seba379/PoliClock/mechanical/cad/concept_rapporto.txt

CONCEPT VOXEL v2 DELLA STATUETTA - PoliClock (DEC-053, DEC-054)
Generato da mechanical/cad/concept_voxel.py; quote in mm, Z dal tavolo.

== Quote principali ==
Ingombro totale: 78.5 (largh.) x 76.3 (prof.) x 153.1 (alt.)
Base: 78.5 x 76.3 x 24.1
Testa: 48 x 40 x 48, da Z 90.1 a 138.1; cappello fino a Z 153.1
Display: centro del vetro a Z 111.1, finestra Ø 38; piastra del volto 40 mm (cornice di pelle di 1 mm ai lati)
Aletta del modulo fino a Z 84.3 (5.8 mm dentro il busto); spina Dupont a Z 86.8, da Y -9.2 a 7.3
Stivali Z 24.1-34.1, pantaloni -58.1, cintura -62.1, busto -90.1
Testa con cappello / altezza: 0.41; altezza in teste (con cappello): 2.43

== Parti (concept) ==
base_guscio        base         31.12 cm3   78.5 x  76.3 x  24.1  - Capovolta (piano superiore sul piatto)
base_fondo         fondo        15.48 cm3   73.9 x  72.7 x  20.1  - Piatta; è lo sportello di servizio (OPEN-008)
stivale_dx         nero          3.70 cm3   17.0 x  26.0 x  10.0  - Suola sul piatto
stivale_sx         nero          3.70 cm3   17.0 x  26.0 x  10.0  - Suola sul piatto
pantaloni          pantaloni    14.56 cm3   34.0 x  22.0 x  24.0  - In piedi; banda rossa incastrata o dipinta
banda_dx           rosso         0.05 cm3    0.7 x   2.8 x  23.6  - Listello 0,8 mm: meglio dipinto se il servizio non regge lo spessore
banda_sx           rosso         0.05 cm3    0.7 x   2.8 x  23.6  - Listello 0,8 mm: meglio dipinto se il servizio non regge lo spessore
cintura            nero          4.46 cm3   49.0 x  28.1 x  17.0  - Anello con fondina e tasca; le spine Ø 3 attraversano
fibbia             grigio        0.04 cm3    8.0 x   1.6 x   2.8  - Piastrina incastrata nella cintura
busto              camicia      25.32 cm3   55.2 x  29.4 x  28.0  - In piedi; cavità in cima per l'aletta del display
braccio_dx         pelle         1.23 cm3    7.0 x  10.0 x  18.0  - Avambraccio e mano; spina Ø 3 nella manica
spallina_dx        rosso         0.12 cm3    8.5 x  10.0 x   1.4  - Piastrina 1,4 mm sulla manica
grado_dx           oro           0.01 cm3    3.5 x   6.0 x   0.6  - Dettaglio 0,6 mm: dipinto se troppo sottile per il servizio
braccio_sx         pelle         1.23 cm3    7.0 x  10.0 x  18.0  - Avambraccio e mano; spina Ø 3 nella manica
spallina_sx        rosso         0.12 cm3    8.5 x  10.0 x   1.4  - Piastrina 1,4 mm sulla manica
grado_sx           oro           0.01 cm3    3.5 x   6.0 x   0.6  - Dettaglio 0,6 mm: dipinto se troppo sottile per il servizio
targhetta          targhetta     0.05 cm3   10.8 x   0.9 x   5.3  - Piastrina
scritta_polizia    bianco        0.01 cm3   10.8 x   0.5 x   2.1  - Lettere in rilievo 0,5 mm: stampa multicolore o pittura
toppa_verde        verde         0.02 cm3    3.6 x   0.9 x   5.3  - Piastrina
toppa_bianco       bianco        0.02 cm3    3.6 x   0.9 x   5.3  - Piastrina
toppa_rosso        rosso         0.02 cm3    3.6 x   0.9 x   5.3  - Piastrina
testa_fronte       capelli       4.41 cm3   48.0 x   8.0 x  48.0  - Cornice dei capelli attorno al volto; si unisce a testa_retro (viti M2 dal pavimento)
testa_retro        capelli      23.61 cm3   55.0 x  32.0 x  48.0  - Guscio posteriore con la coda: retro sul piatto, supporti sotto la coda
volto              pelle         0.89 cm3   39.8 x   2.0 x  40.9  - Cornice 2 mm con la finestra Ø 38: il display è tutto il volto
cappello           cappello     13.37 cm3   54.0 x  47.0 x  15.0  - Capovolto (cima sul piatto): la fascia sporge di 2–5 mm
fregio             oro           0.03 cm3    9.8 x   0.8 x   9.8  - Rilievo 0,8 mm a pixel 1,4 mm

== Controlli ==
  Sovrapposizioni fra parti: PASS
  Modulo display (tondo + aletta) e spina senza interferenze: PASS (0.00 mm3)
  Canale 21 x 6 libero dalla base alla cavità del busto: PASS (0.00 mm3)
  Interferenze nella base e distanze dall'antenna: vedi studio_base_rapporto.txt (stessa base, spigoli 5/4 mm)
  Cavetto display: percorso fra le spine circa 68 mm; Dupont da 10 cm (ok, almeno 15 mm di gioco per sfilare la testa)
