seba379/PoliClock/assets/concept/policlock-chibi-concept.png

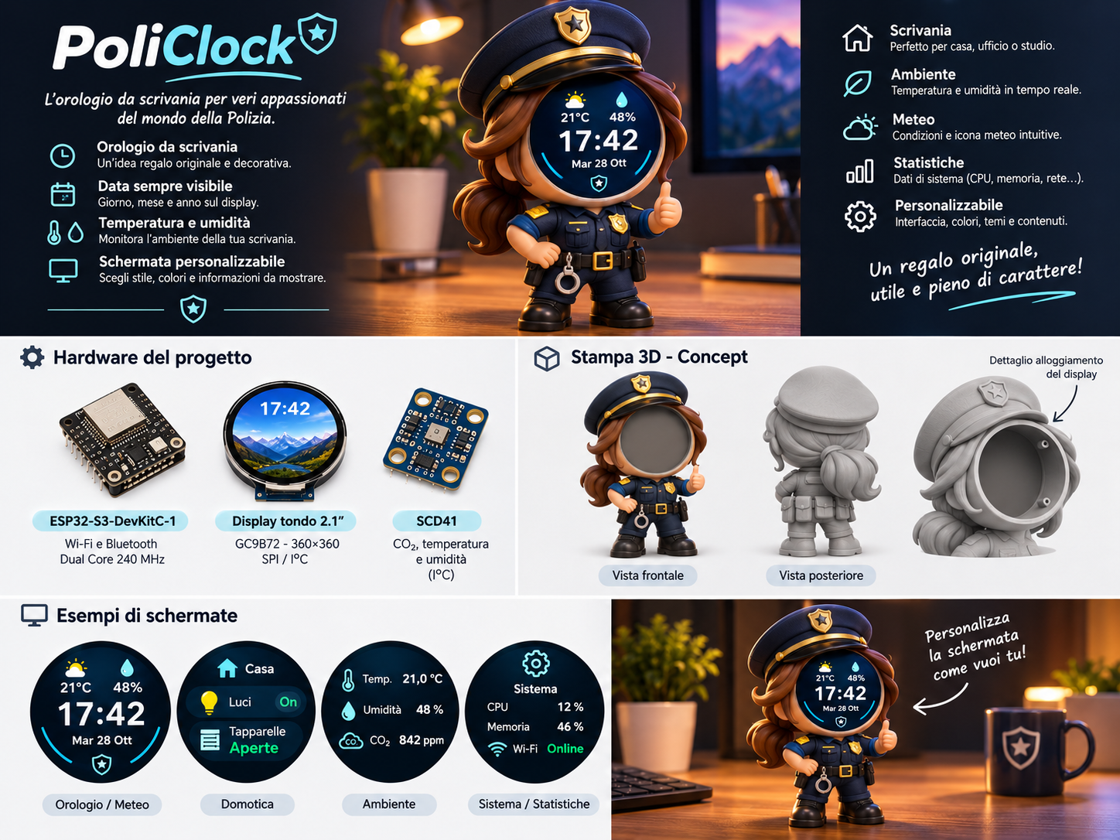
assets/concept/policlock-chibi-concept.png
