seba379/PoliClock/assets/concept/riferimento-stile-chibi-voxel.webp

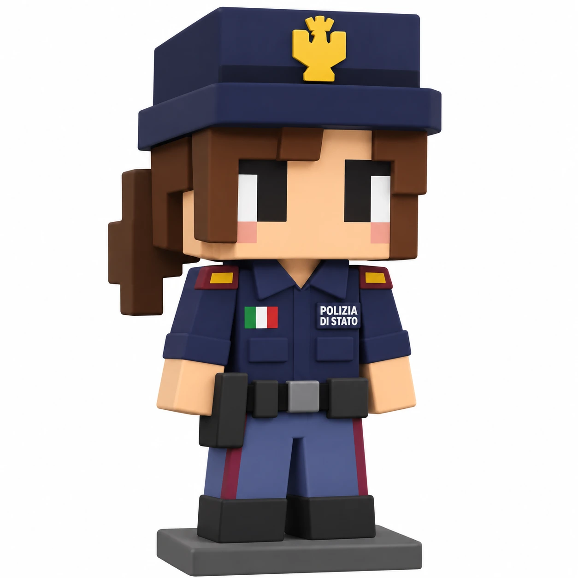
assets/concept/riferimento-stile-chibi-voxel.webp
