seba379/PoliClock/assets/renders/blockout-fronte.png

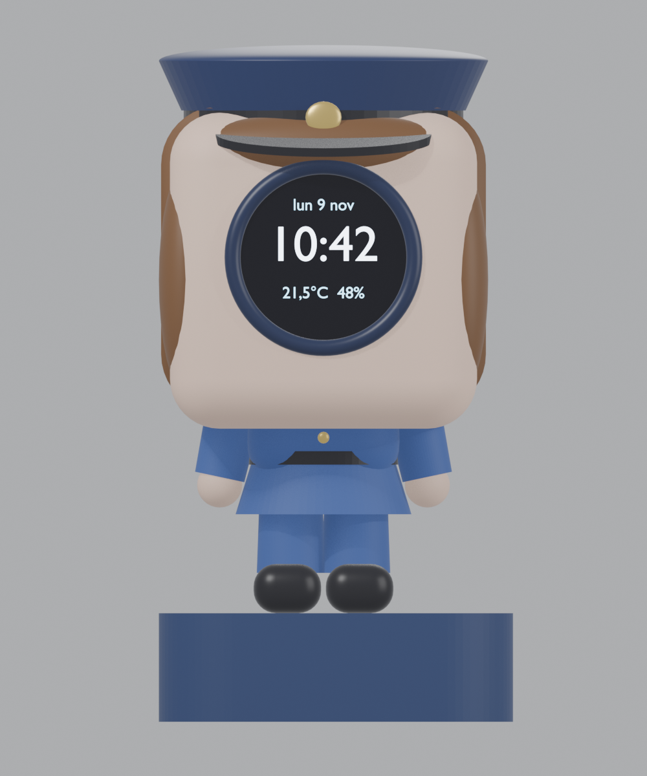
assets/renders/blockout-fronte.png
