seba379/PoliClock/assets/renders/blockout-lato.png

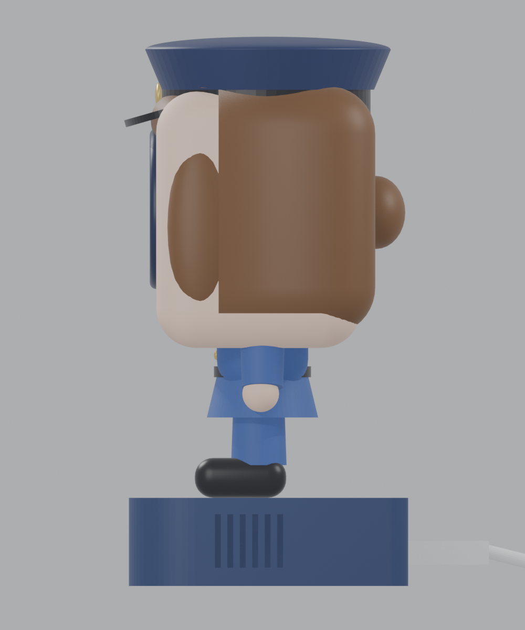
assets/renders/blockout-lato.png
