seba379/PoliClock/assets/renders/blockout-retro.png

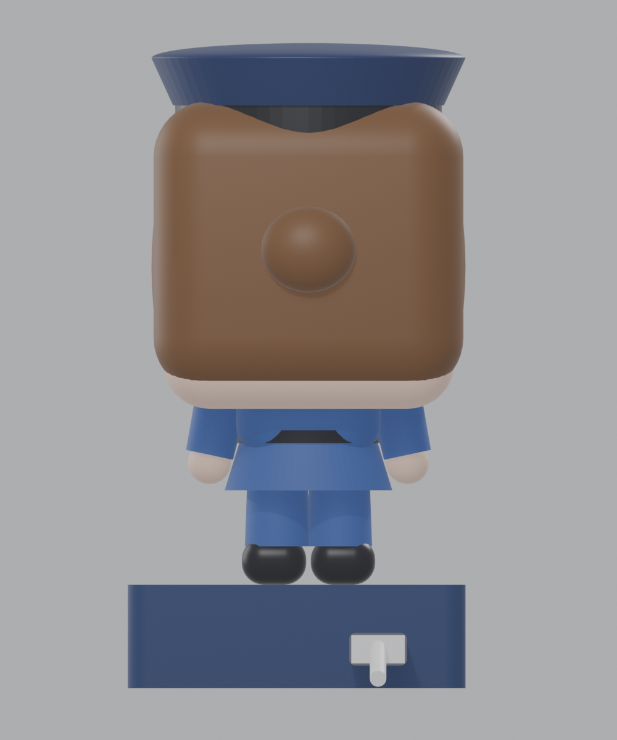
assets/renders/blockout-retro.png
