seba379/PoliClock/assets/renders/blockout-sezione-base-3q.png

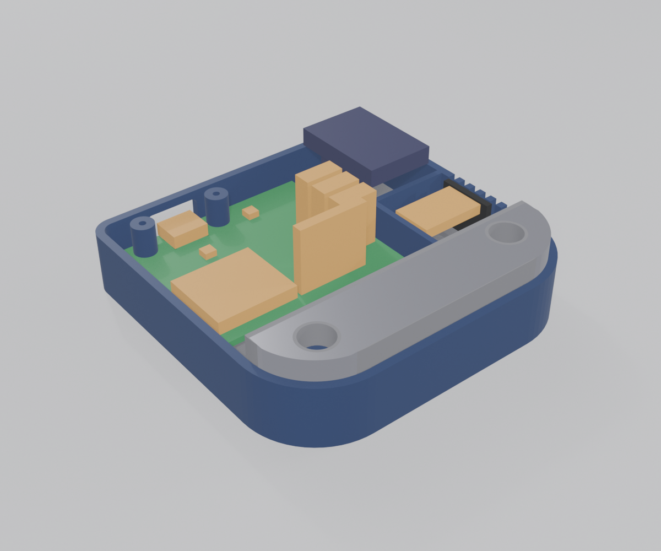
assets/renders/blockout-sezione-base-3q.png
