seba379/PoliClock/assets/renders/blockout-sezione-base.png

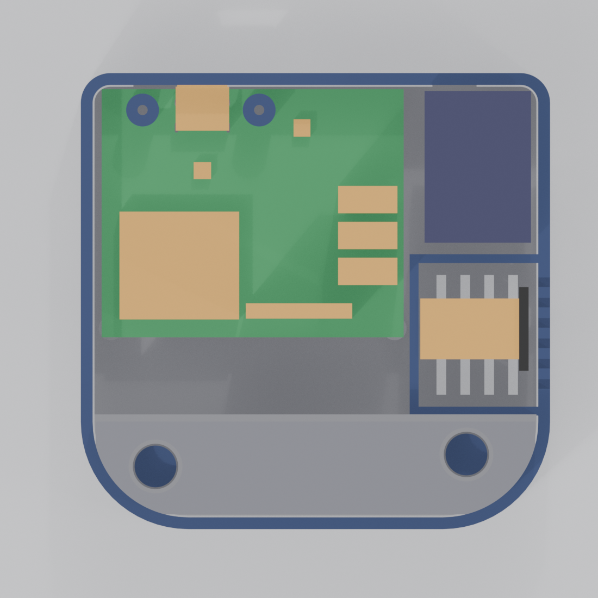
assets/renders/blockout-sezione-base.png
