seba379/PoliClock/assets/renders/blockout-tre-quarti.png

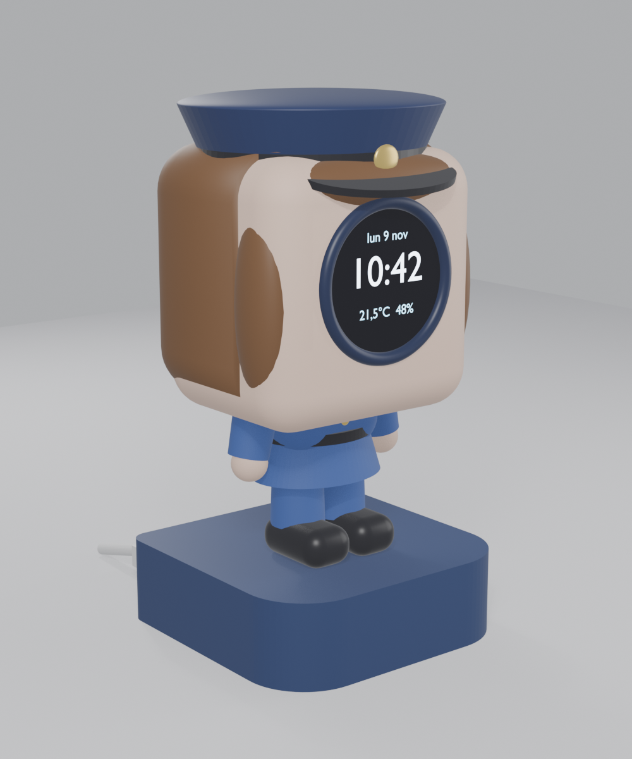
assets/renders/blockout-tre-quarti.png
