seba379/PoliClock/assets/renders/concept-esploso.png

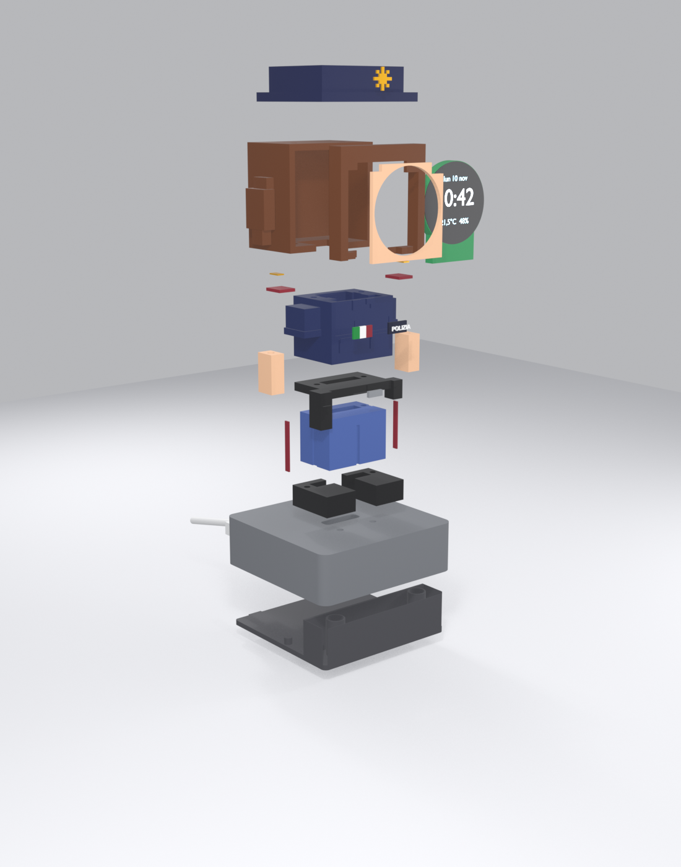
assets/renders/concept-esploso.png
