seba379/PoliClock/assets/renders/concept-fronte-emoji.png

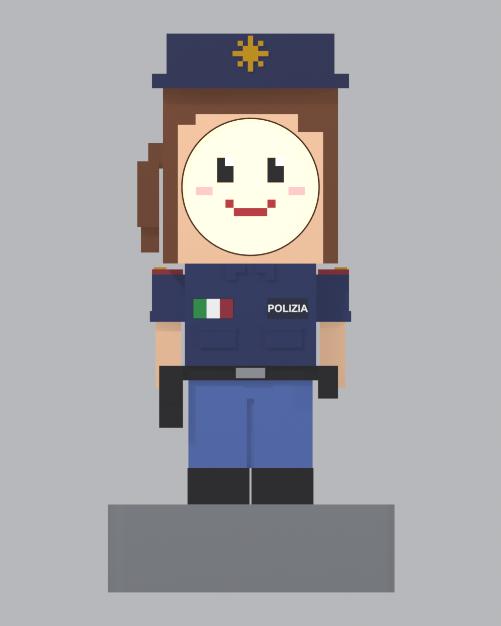
assets/renders/concept-fronte-emoji.png
