seba379/PoliClock/assets/renders/concept-fronte.png

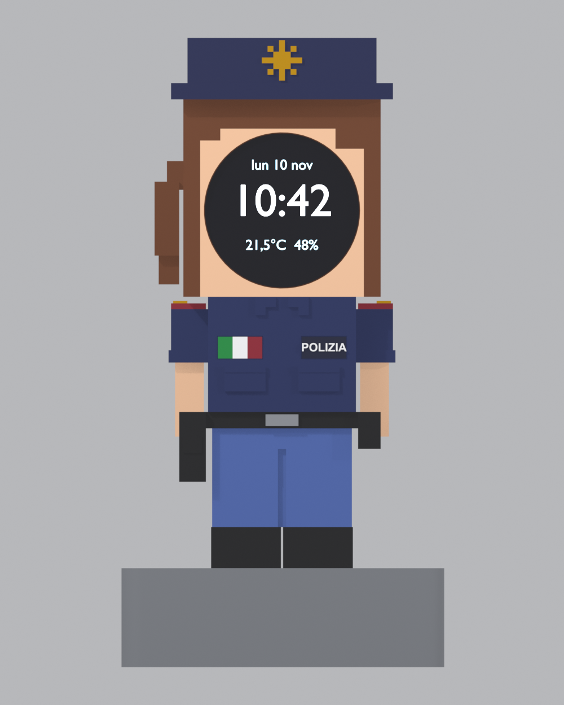
assets/renders/concept-fronte.png
