seba379/PoliClock/assets/renders/concept-lato.png

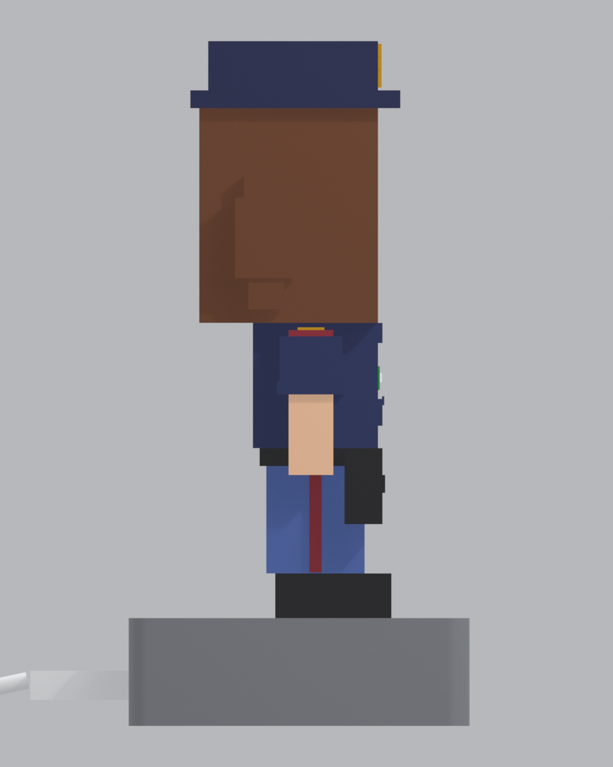
assets/renders/concept-lato.png
