seba379/PoliClock/assets/renders/concept-retro.png

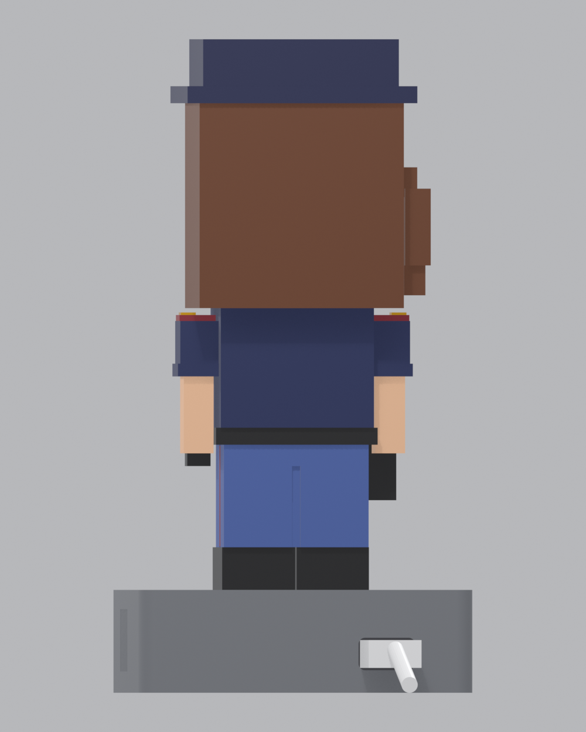
assets/renders/concept-retro.png
