seba379/PoliClock/assets/renders/concept-sezione.png

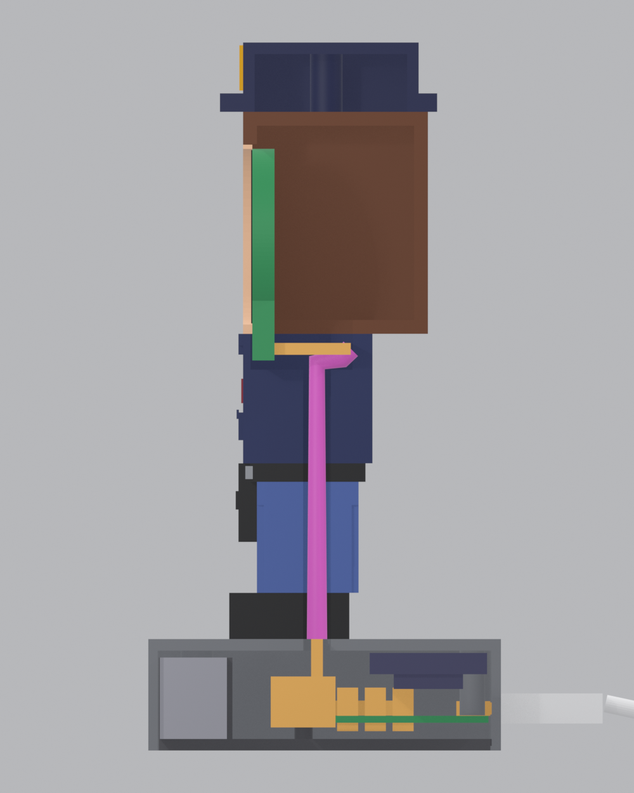
assets/renders/concept-sezione.png
