seba379/PoliClock/assets/renders/concept-tre-quarti-emoji.png

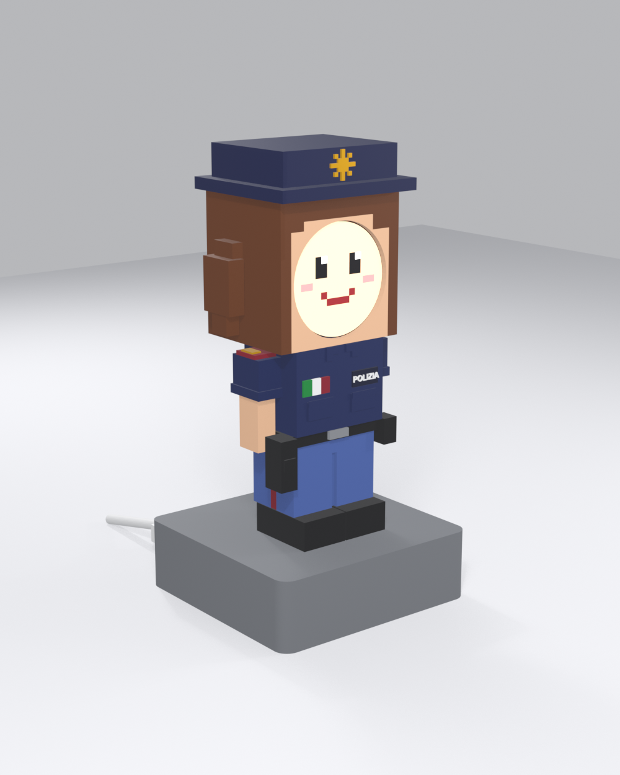
assets/renders/concept-tre-quarti-emoji.png
