seba379/PoliClock/hardware/policlock-main/policlock-main-bottom.png

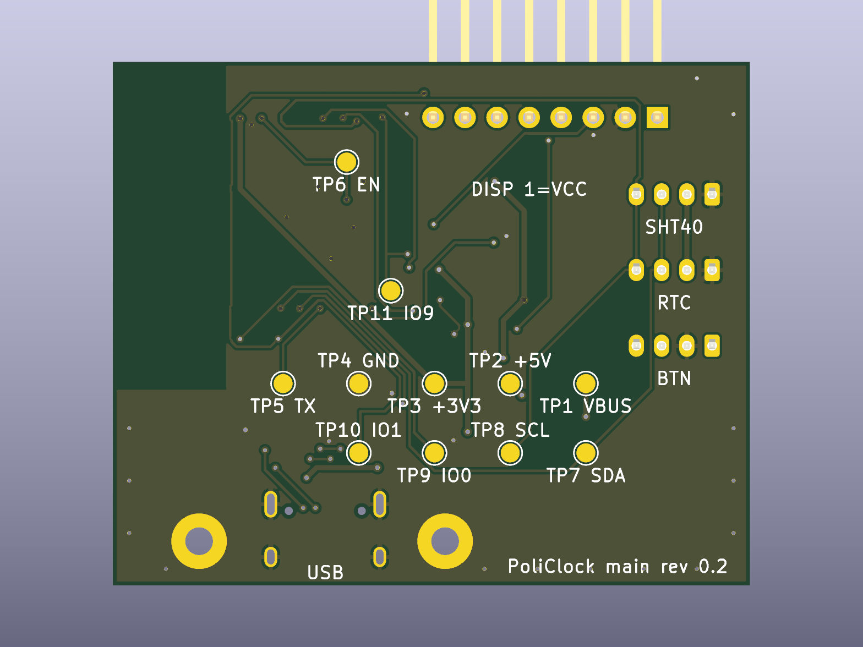
hardware/policlock-main/policlock-main-bottom.png
