seba379/PoliClock/hardware/policlock-main/policlock-main-top.png

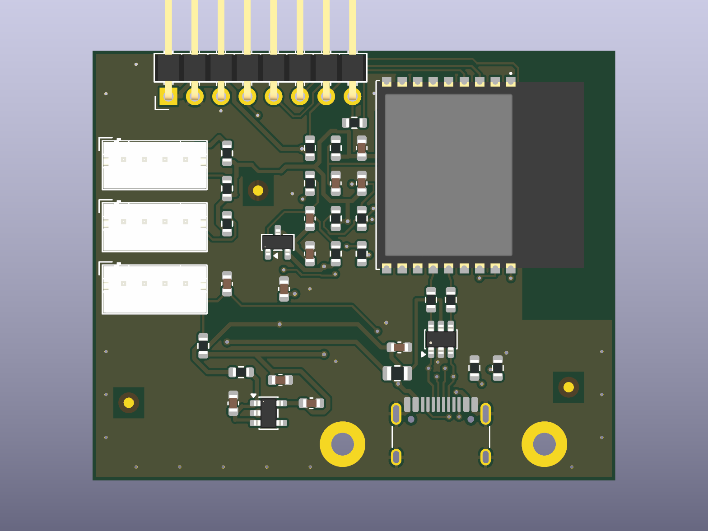
hardware/policlock-main/policlock-main-top.png
