seba379/PoliClock/hardware/policlock-main/policlock-main-bom-completa.csv

Riferimenti | Valore | Footprint | LCSC | Qta | DNP | Montaggio | Note
C1,C7 | 1uF | Capacitor_SMD:C_0603_1608Metric | C15849 | 2 |  | JLC (PCBA) | Unpolarized capacitor
C2 | 4.7uF | Capacitor_SMD:C_0603_1608Metric | C19666 | 1 |  | JLC (PCBA) | Unpolarized capacitor
C3,C5,C9 | 10uF | Capacitor_SMD:C_0603_1608Metric | C19702 | 3 |  | JLC (PCBA) | Unpolarized capacitor
C4,C6,C8,C10 | 100nF | Capacitor_SMD:C_0603_1608Metric | C14663 | 4 |  | JLC (PCBA) | Unpolarized capacitor
C11 | 10nF | Capacitor_SMD:C_0603_1608Metric | C57112 | 1 |  | JLC (PCBA) | Gate-drain di Q1: rampa di accensione del display (FIN-003)
F1 | BSMD0805-050-12V | Fuse:Fuse_0805_2012Metric | C2977522 | 1 |  | JLC (PCBA) | PTC BSMD0805-050-12V: hold 0,5 A / trip 1 A
J1 | TYPE-C-31-M-12 | PoliClock:USB_C_Receptacle_HRO_TYPE-C-31-M-12 | C165948 | 1 |  | JLC (PCBA) | Ricettacolo USB-C 16P HRO, solo USB 2.0 (footprint libreria KiCad dal disegno HRO)
J2 | Header 1x8 2,54 mm THT | Connector_PinHeader_2.54mm:PinHeader_1x08_P2.54mm_Horizontal |  | 1 |  | a mano, parte del proprietario | Header maschio 1x8 2,54 mm a foro passante, a 90 gradi (va bene anche diritto): cavo Dupont 7 fili sui pin 1-7 verso il modulo GC9A01; pin 8 BUSY per un eventuale e-paper (DEC-049)
J3-J5 | B4B-PH-K-S | Connector_JST:JST_PH_B4B-PH-K_1x04_P2.00mm_Vertical |  | 3 |  | a mano, parte del proprietario | JST PH 4 poli: modulo RTC DS3231,JST PH 4 poli: modulo SHT40,JST PH 4 poli: pulsante utente remoto (pin 1-2), pin 3-4 non collegati
Q1 | AO3401A | Package_TO_SOT_SMD:SOT-23 | C15127 | 1 |  | JLC (PCBA) | -4.0A Id, -30V Vds, P-Channel MOSFET, SOT-23
R1,R2 | 5.1k | Resistor_SMD:R_0603_1608Metric | C23186 | 2 |  | JLC (PCBA) | CC1 pull-down Rd 5,1 k (sink USB-C),CC2 pull-down Rd 5,1 k (sink USB-C)
R3-R5,R21 | 0Ω | Resistor_SMD:R_0603_1608Metric | C21189 | 4 |  | JLC (PCBA) | 0 ohm: isola USB D+ (eventuale 22 ohm),0 ohm: isola USB D- (eventuale 22 ohm),0 ohm: isola il regolatore per il bring-up,0 ohm: isola l'alimentazione dei moduli esterni
R6,R7,R15,R16,R22 | 10k | Resistor_SMD:R_0603_1608Metric | C25804 | 5 |  | JLC (PCBA) | Pull-up pulsante (attivo basso),Pull-up reset verso l'alimentazione del modulo,Pull-up strapping IO9 (SPI boot),RC su EN (Espressif: R 10 k, C 1 uF),Resistenza di gate 10 k: con C11 rampa di accensione lenta (FIN-003)
R8,R9 | 22Ω | Resistor_SMD:R_0603_1608Metric | C23345 | 2 |  | JLC (PCBA) | Smorzamento MOSI (valore da M1),Smorzamento SCLK (valore da M1)
R17 | 100k | Resistor_SMD:R_0603_1608Metric | C25803 | 1 |  | JLC (PCBA) | Gate verso source: modulo spento di default
R19,R20 | 4.7k | Resistor_SMD:R_0603_1608Metric | C23162 | 2 |  | JLC (PCBA) | Pull-up I2C SCL (anche strapping IO8),Pull-up I2C SDA (anche strapping IO2)
R23 | 1k | Resistor_SMD:R_0603_1608Metric | C21190 | 1 |  | JLC (PCBA) | Serie su BUSY (e-paper, DEC-049): limita la corrente con il modulo spento o un conflitto
U1 | USBLC6-2SC6 | Package_TO_SOT_SMD:SOT-23-6 | C7519 | 1 |  | JLC (PCBA) | Very low capacitance ESD protection diode, 2 data-line, SOT-23-6
U2 | TLV75533PDBVR | Package_TO_SOT_SMD:SOT-23-5 | C404027 | 1 |  | JLC (PCBA) | LDO 500 mA, stabile con MLCC >= 1 uF (TI SBVS320D)
U3 | ESP32-C3-WROOM-02-N4 | PoliClock:ESP32-C3-WROOM-02 | C2934560 | 1 |  | JLC (PCBA) | ESP32-C3-WROOM-02-N4 (DEC-044): assemblaggio JLC Economic; radio non usata in V1 (DEC-012)
