seba379/PoliClock/hardware/policlock-main/policlock-main-scheda.step

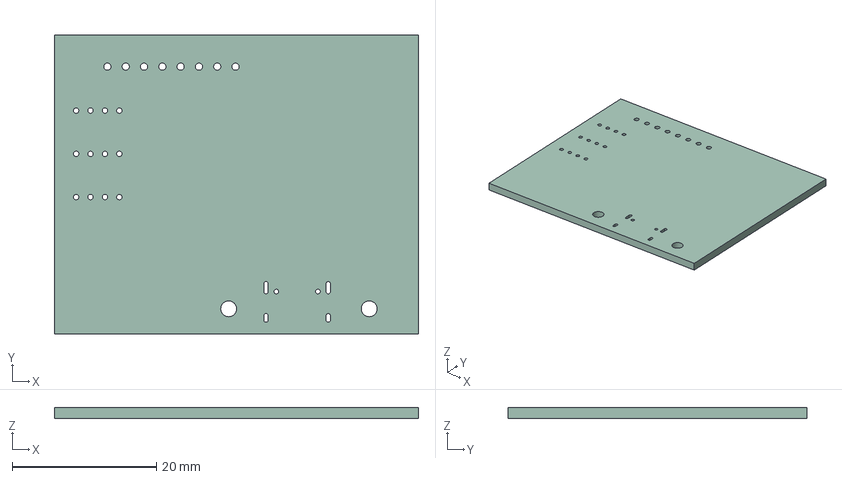
[picture p19: CAD file, 2026-11-09]
hardware/policlock-main/policlock-main-scheda.step
50.5 x 41.5 x 1.51 mm
