seba379/PoliClock/mechanical/prints/concept/testa_retro.stl

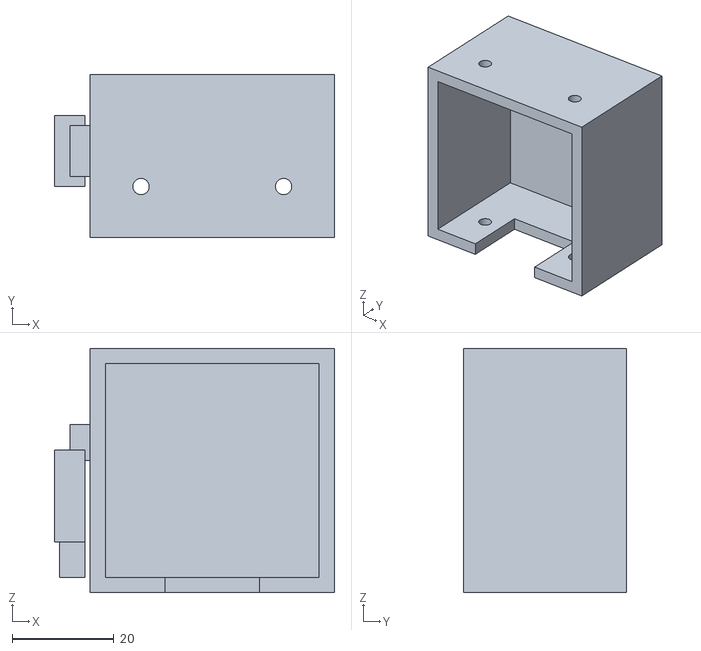
[picture p20: CAD file, 2026-11-10]
mechanical/prints/concept/testa_retro.stl
55.0 x 32.0 x 48.0
