seba379/PoliClock/mechanical/prints/studio-volumi-base.step

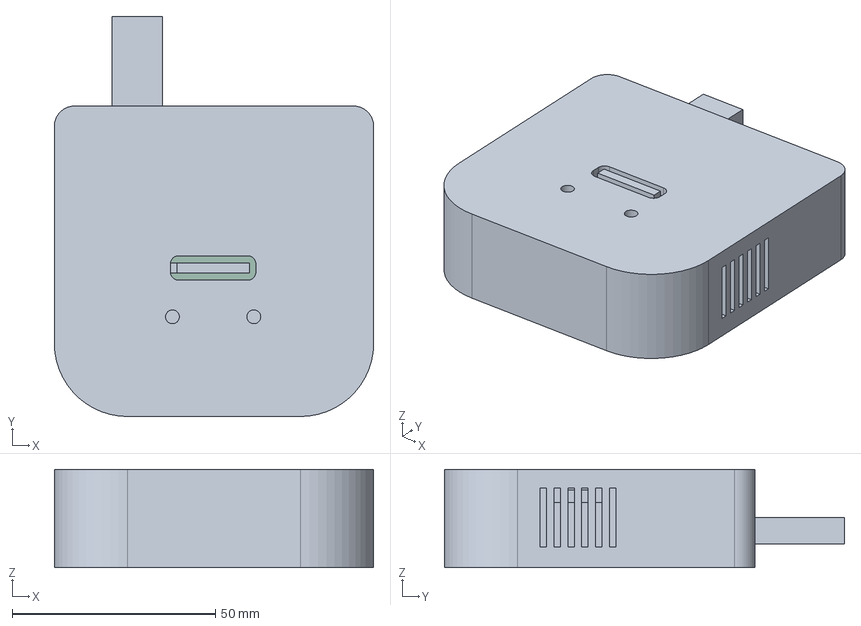
[picture p21: CAD file, 2026-11-10]
mechanical/prints/studio-volumi-base.step
78.5 x 98.3 x 24.1 mm
base guscio
base fondo
policlock-main_PCB
U3 WROOM-02
J3 SHT40
J4 RTC
J5 pulsante
J1 USB-C
U2 LDO
U1 ESD
spina J3 SHT40
spina J4 RTC
spina J5 pulsante
J2 header diritto
spina Dupont display
DS3231 (5188)
DS3231 pila CR1220
SHT40 modulo
SHT40 spina
spina USB-C (sovrastampo)
spina USB-C (guscio)
zavorra
