seba379/PoliClock/mechanical/prints/base-fondo.stl

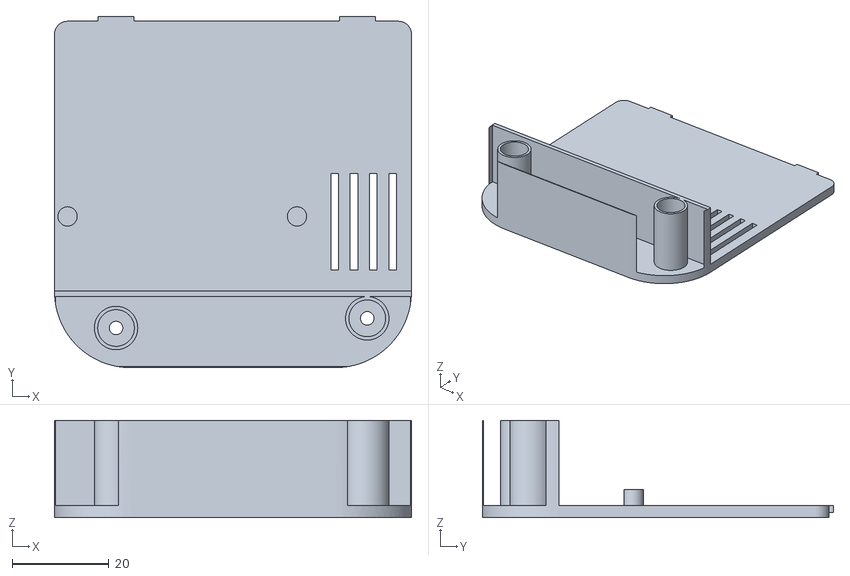
[picture p22: CAD file, 2026-11-10]
mechanical/prints/base-fondo.stl
73.9 x 72.7 x 20.1
