seba379/PoliClock/mechanical/prints/concept/grado_sx.stl

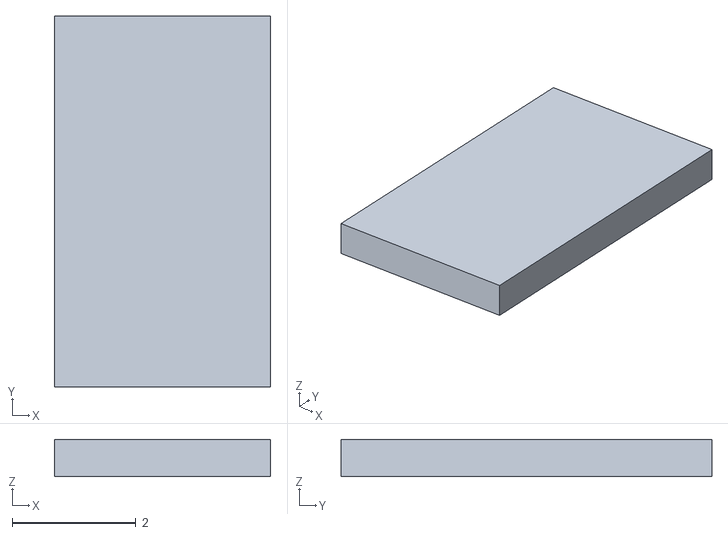
[picture p23: CAD file, 2026-11-10]
mechanical/prints/concept/grado_sx.stl
3.50 x 6.00 x 0.6
