seba379/PoliClock/mechanical/prints/base-guscio.stl

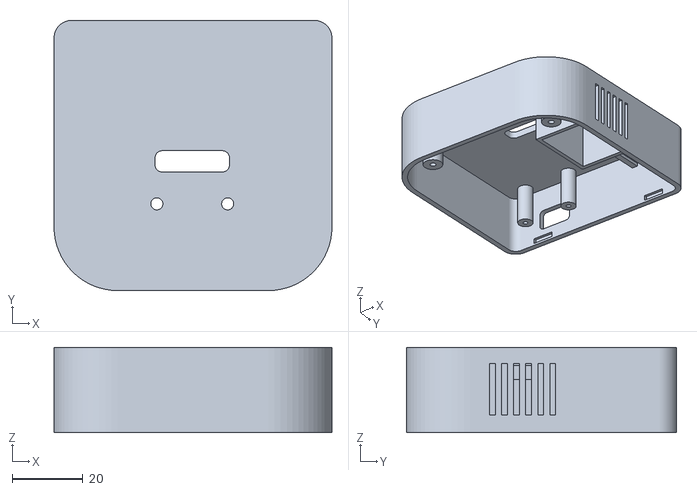
[picture p24: CAD file, 2026-11-10]
mechanical/prints/base-guscio.stl
78.5 x 76.3 x 24.1
