seba379/PoliClock/mechanical/prints/concept/volto.stl

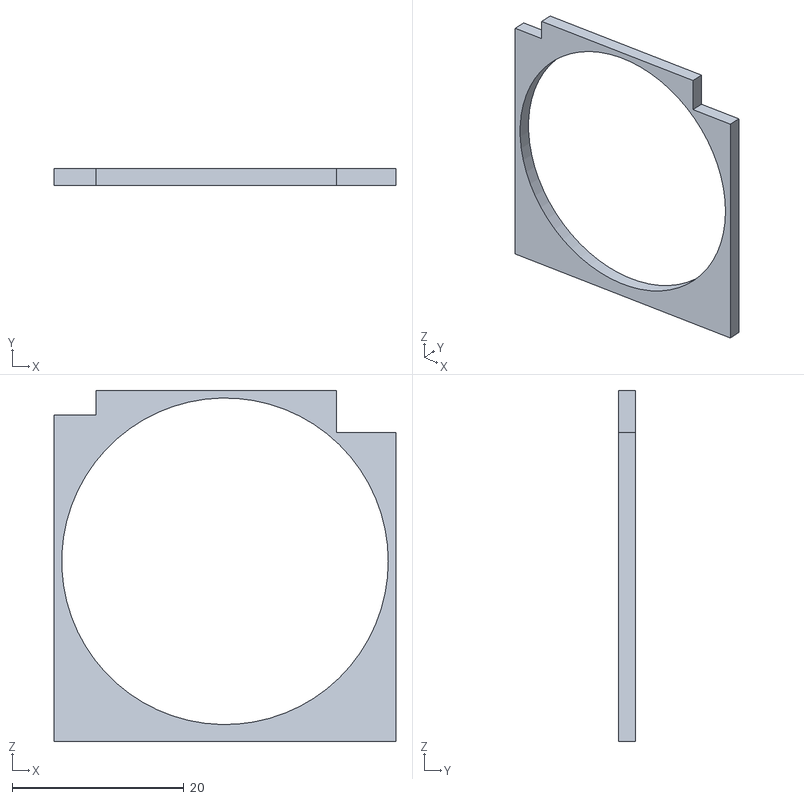
[picture p25: CAD file, 2026-11-10]
mechanical/prints/concept/volto.stl
39.8 x 2.00 x 40.9
