seba379/PoliClock/mechanical/prints/concept-statuetta.step

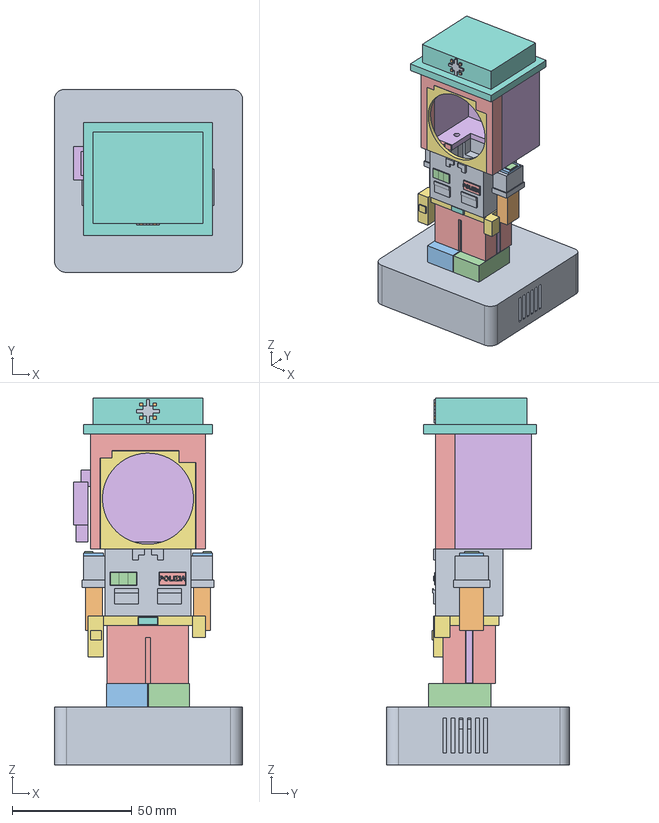
[picture p26: CAD file, 2026-11-10]
mechanical/prints/concept-statuetta.step
78.5 x 76.3 x 153.1 mm
base_guscio
base_fondo
stivale_dx
stivale_sx
pantaloni
banda_dx
banda_sx
cintura
fibbia
busto
braccio_dx
spallina_dx
grado_dx
braccio_sx
spallina_sx
grado_sx
targhetta
scritta_polizia
toppa_verde
toppa_bianco
toppa_rosso
testa_fronte
testa_retro
volto
cappello
fregio
