seba379/PoliClock/mechanical/prints/concept/braccio_sx.stl

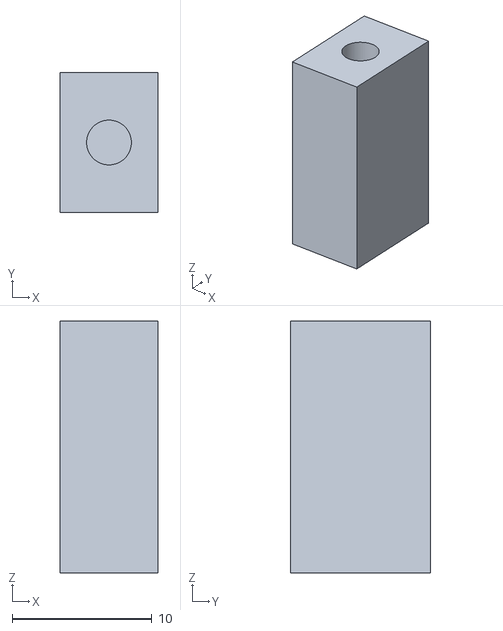
[picture p27: CAD file, 2026-11-10]
mechanical/prints/concept/braccio_sx.stl
7.00 x 10.0 x 18.0
