seba379/PoliClock/mechanical/prints/concept/banda_dx.stl

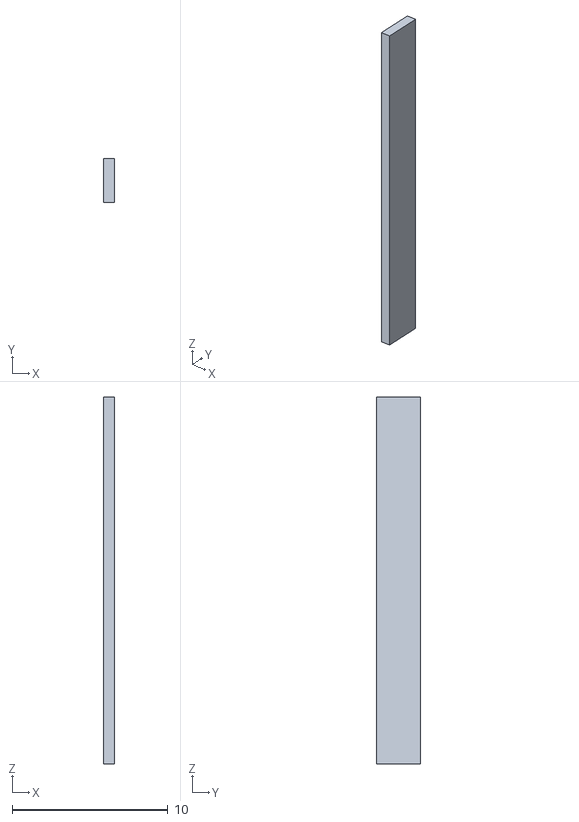
[picture p28: CAD file, 2026-11-10]
mechanical/prints/concept/banda_dx.stl
0.7 x 2.80 x 23.6
