seba379/PoliClock/mechanical/prints/concept/scritta_polizia.stl

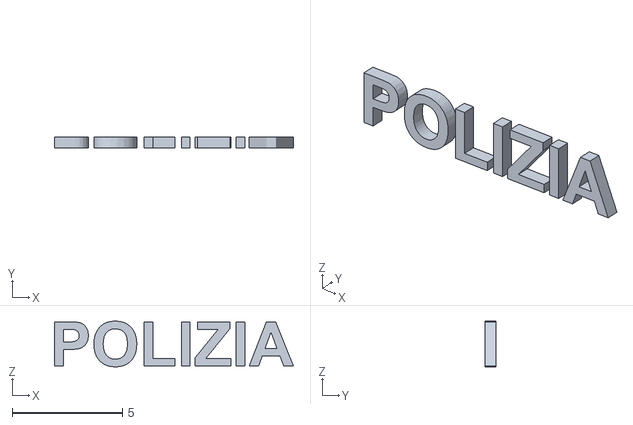
[picture p29: CAD file, 2026-11-10]
mechanical/prints/concept/scritta_polizia.stl
10.8 x 0.5 x 2.07
