seba379/PoliClock/mechanical/prints/concept/testa_fronte.stl

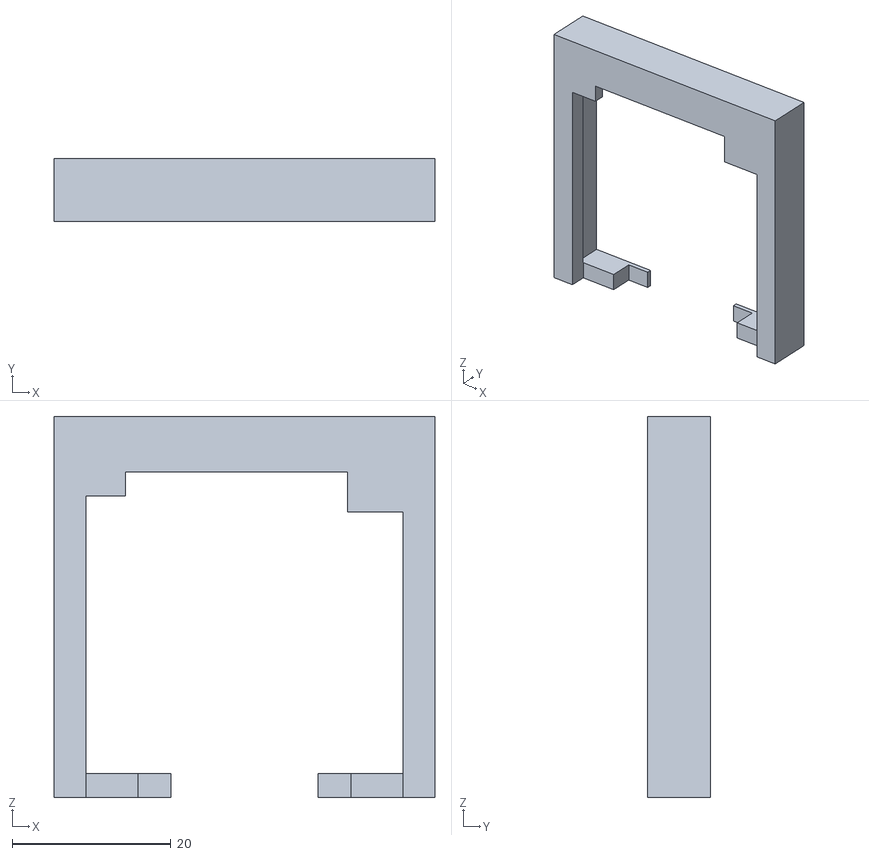
[picture p30: CAD file, 2026-11-10]
mechanical/prints/concept/testa_fronte.stl
48.0 x 8.00 x 48.0
