seba379/PoliClock/mechanical/prints/concept/base_guscio.stl

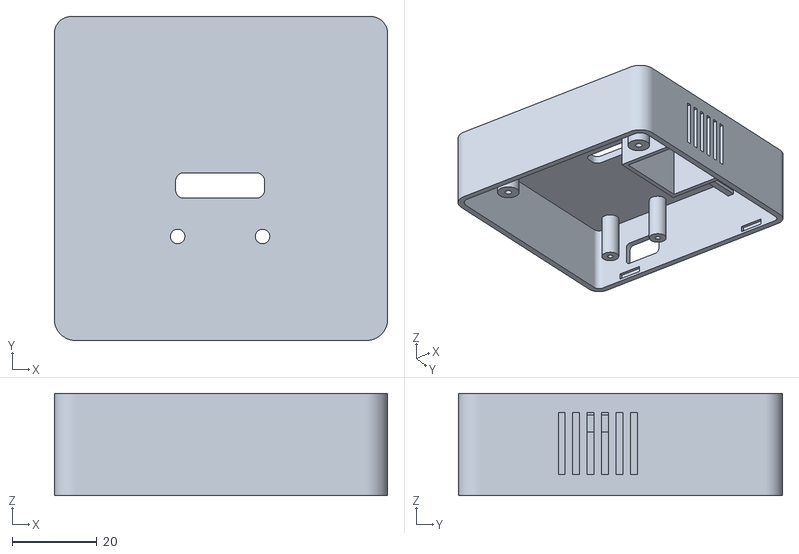
[picture p31: CAD file, 2026-11-10]
mechanical/prints/concept/base_guscio.stl
78.5 x 76.3 x 24.1
