seba379/PoliClock/mechanical/prints/concept/spallina_sx.stl

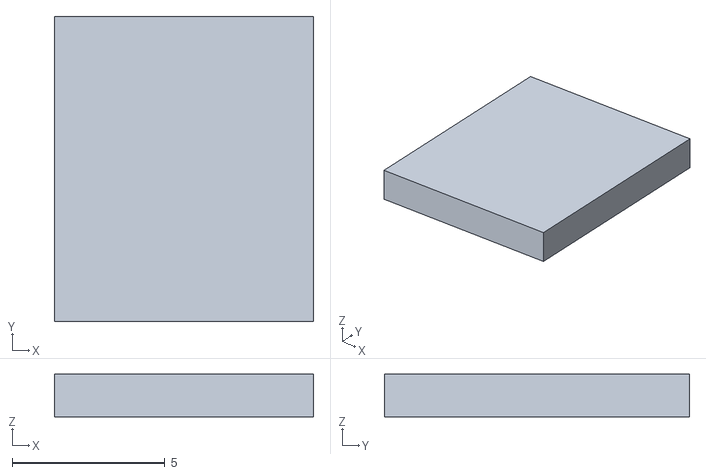
[picture p32: CAD file, 2026-11-10]
mechanical/prints/concept/spallina_sx.stl
8.50 x 10.0 x 1.40
