seba379/PoliClock/mechanical/prints/concept/targhetta.stl

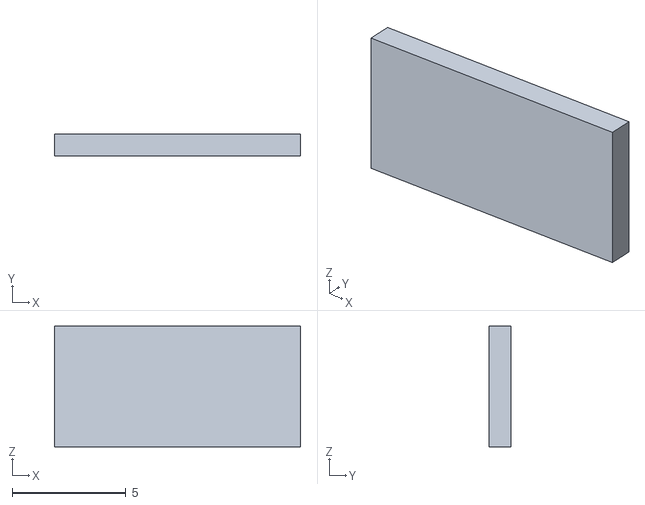
[picture p33: CAD file, 2026-11-10]
mechanical/prints/concept/targhetta.stl
10.8 x 0.95 x 5.30
