seba379/PoliClock/mechanical/prints/concept/fibbia.stl

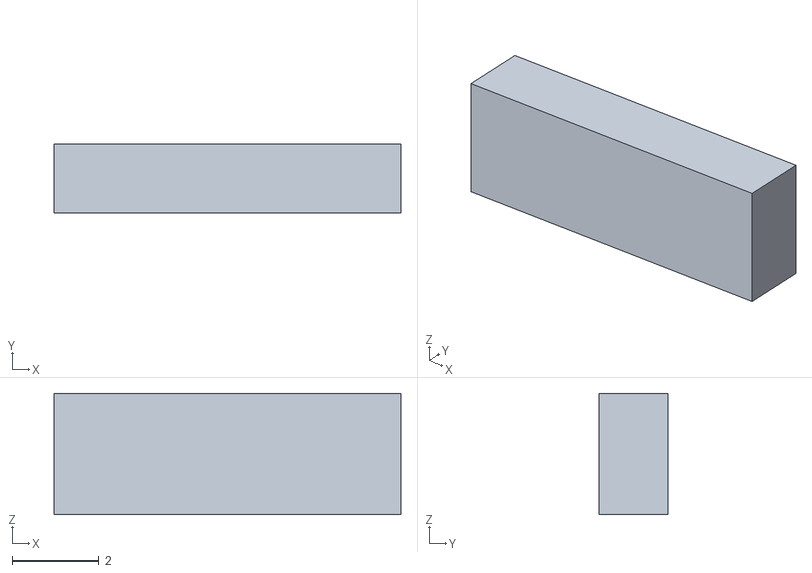
[picture p34: CAD file, 2026-11-10]
mechanical/prints/concept/fibbia.stl
8.00 x 1.60 x 2.80
