seba379/PoliClock/mechanical/prints/concept/stivale_dx.stl

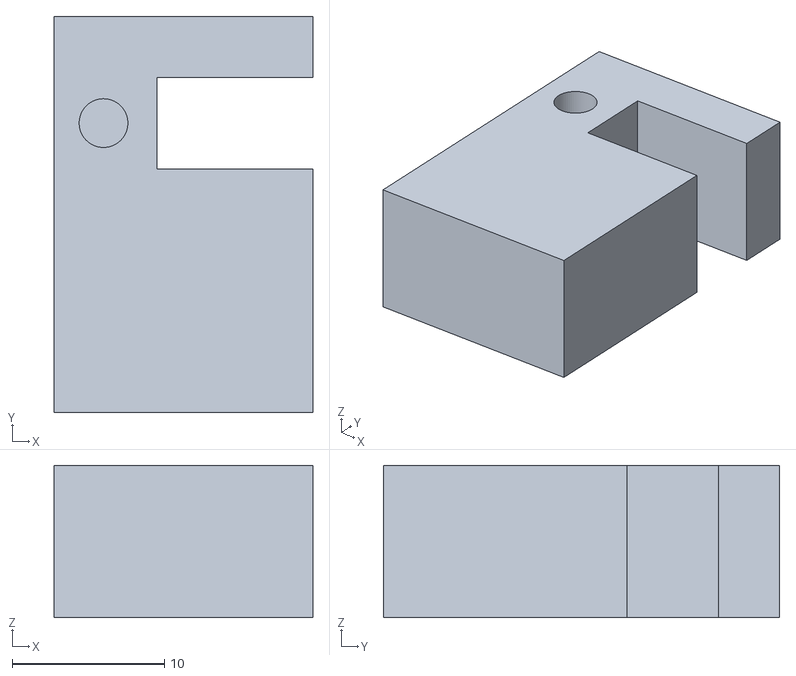
[picture p35: CAD file, 2026-11-10]
mechanical/prints/concept/stivale_dx.stl
17.0 x 26.0 x 10.00
