seba379/PoliClock/mechanical/prints/concept/cappello.stl

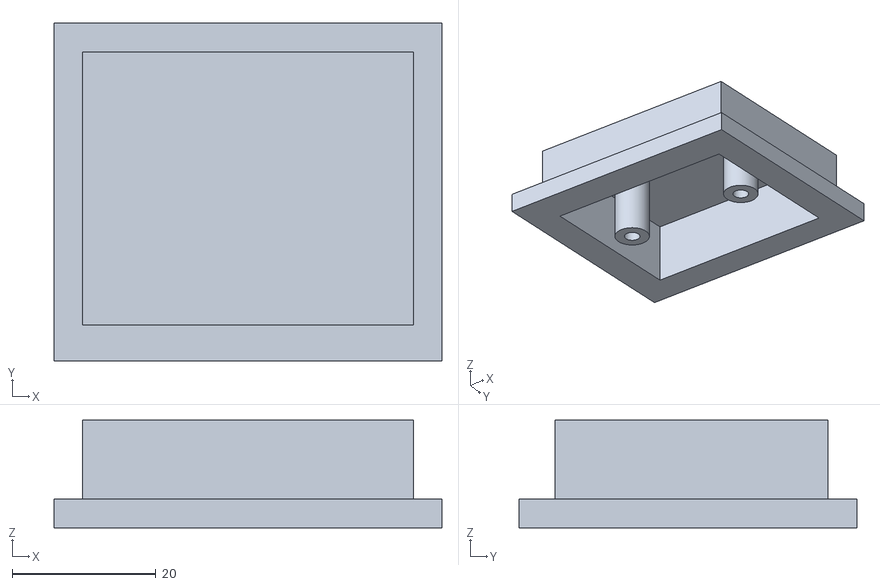
[picture p36: CAD file, 2026-11-10]
mechanical/prints/concept/cappello.stl
54.0 x 47.0 x 15.0
