seba379/PoliClock/mechanical/prints/concept/pantaloni.stl

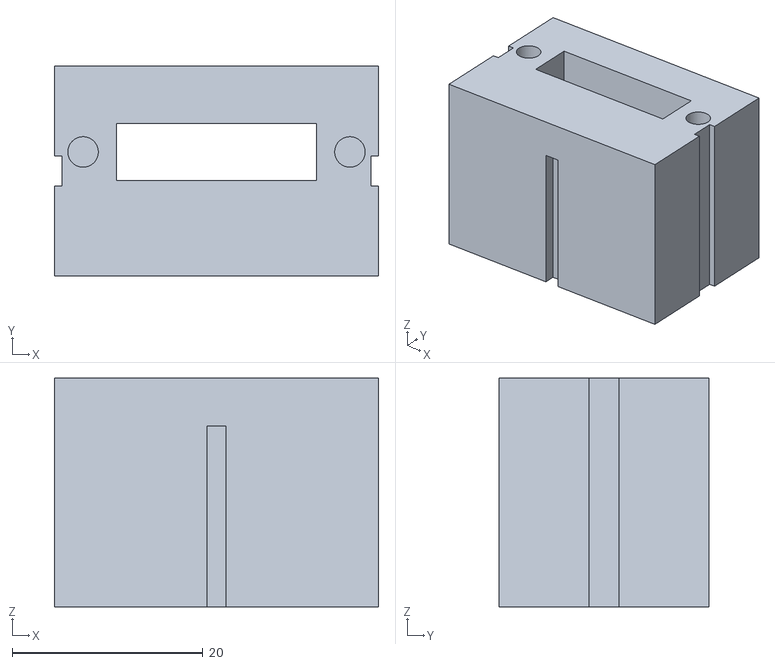
[picture p37: CAD file, 2026-11-10]
mechanical/prints/concept/pantaloni.stl
34.0 x 22.0 x 24.0
