seba379/PoliClock/mechanical/prints/concept/fregio.stl

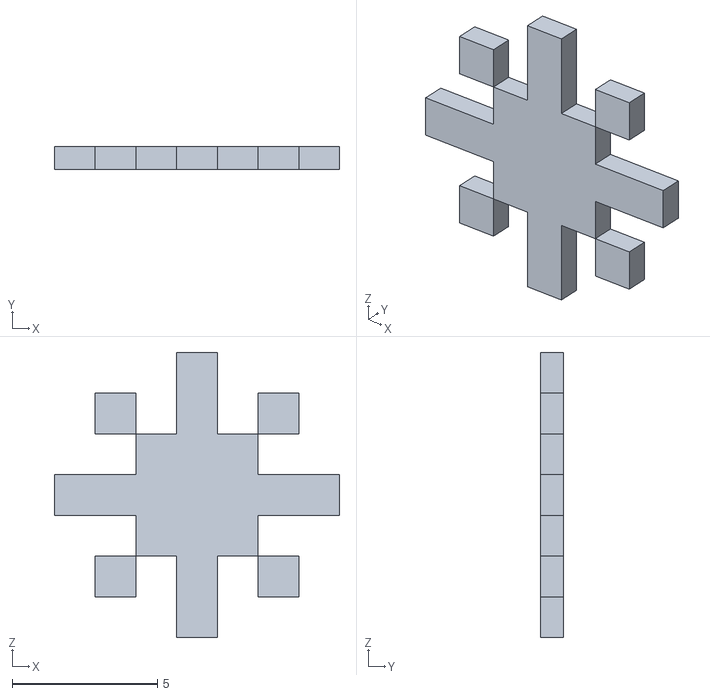
[picture p38: CAD file, 2026-11-10]
mechanical/prints/concept/fregio.stl
9.80 x 0.8 x 9.80
