seba379/PoliClock/mechanical/prints/concept/toppa_bianco.stl

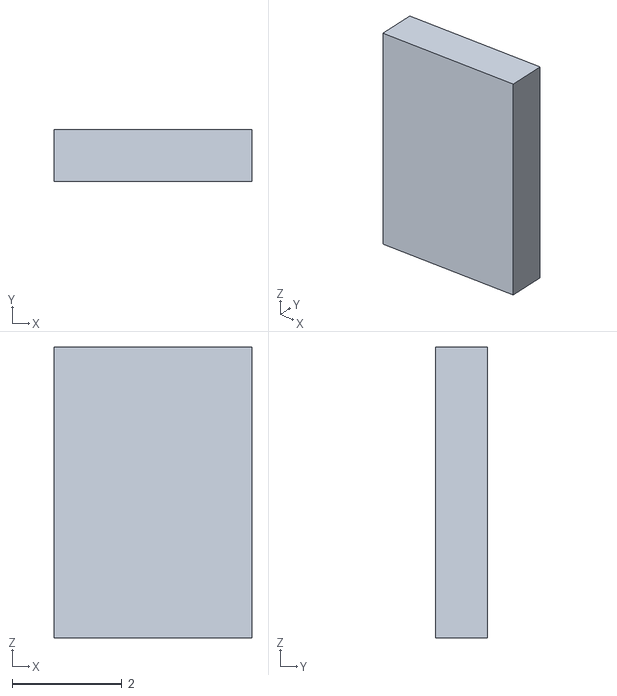
[picture p39: CAD file, 2026-11-10]
mechanical/prints/concept/toppa_bianco.stl
3.60 x 0.95 x 5.30
