seba379/PoliClock/mechanical/prints/concept/cintura.stl

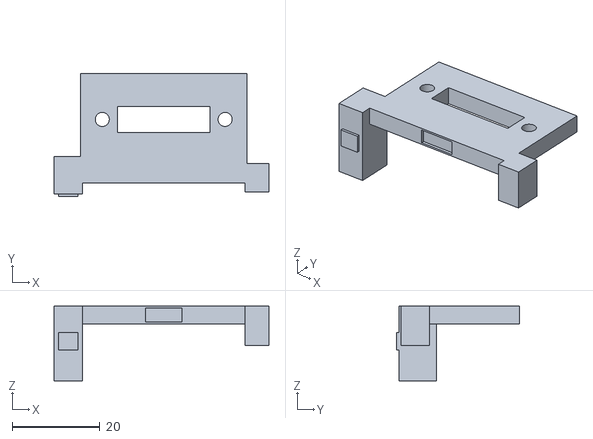
[picture p40: CAD file, 2026-11-10]
mechanical/prints/concept/cintura.stl
49.0 x 28.1 x 17.0
