seba379/PoliClock/mechanical/prints/concept/base_fondo.stl

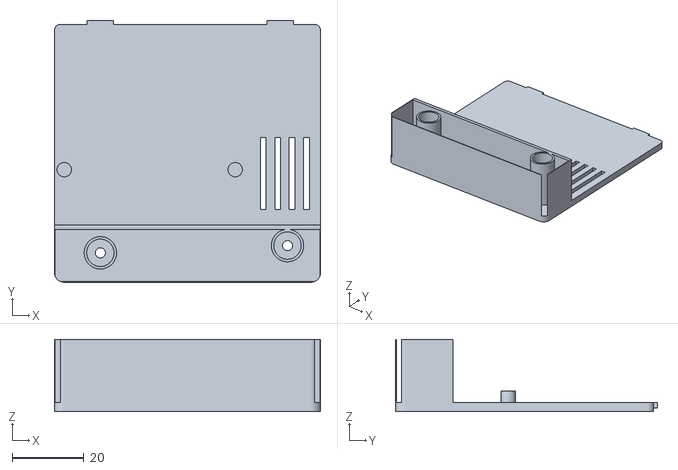
[picture p41: CAD file, 2026-11-10]
mechanical/prints/concept/base_fondo.stl
73.9 x 72.7 x 20.1
