seba379/PoliClock/mechanical/prints/concept/busto.stl

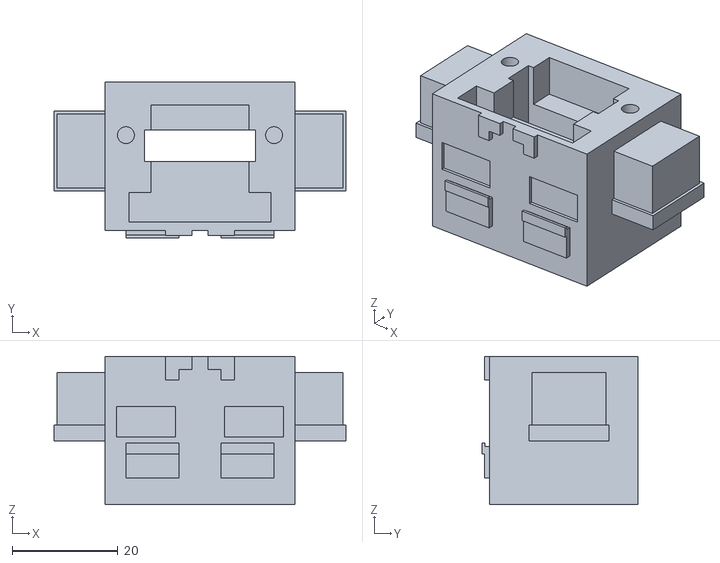
[picture p42: CAD file, 2026-11-10]
mechanical/prints/concept/busto.stl
55.2 x 29.4 x 28.0
