seba379/PoliClock/(list of files, cad)

Other CAD files:
mechanical/prints/concept/grado_dx.stl
mechanical/prints/concept/spallina_dx.stl
mechanical/prints/concept/braccio_dx.stl
mechanical/prints/concept/stivale_sx.stl
mechanical/prints/concept/banda_sx.stl
mechanical/prints/concept/toppa_verde.stl
mechanical/prints/concept/toppa_rosso.stl
mechanical/blender/policlock_blockout.blend
mechanical/blender/policlock_concept.blend
