seba379/PoliClock/hardware/policlock-main/policlock-main-layout.pdf

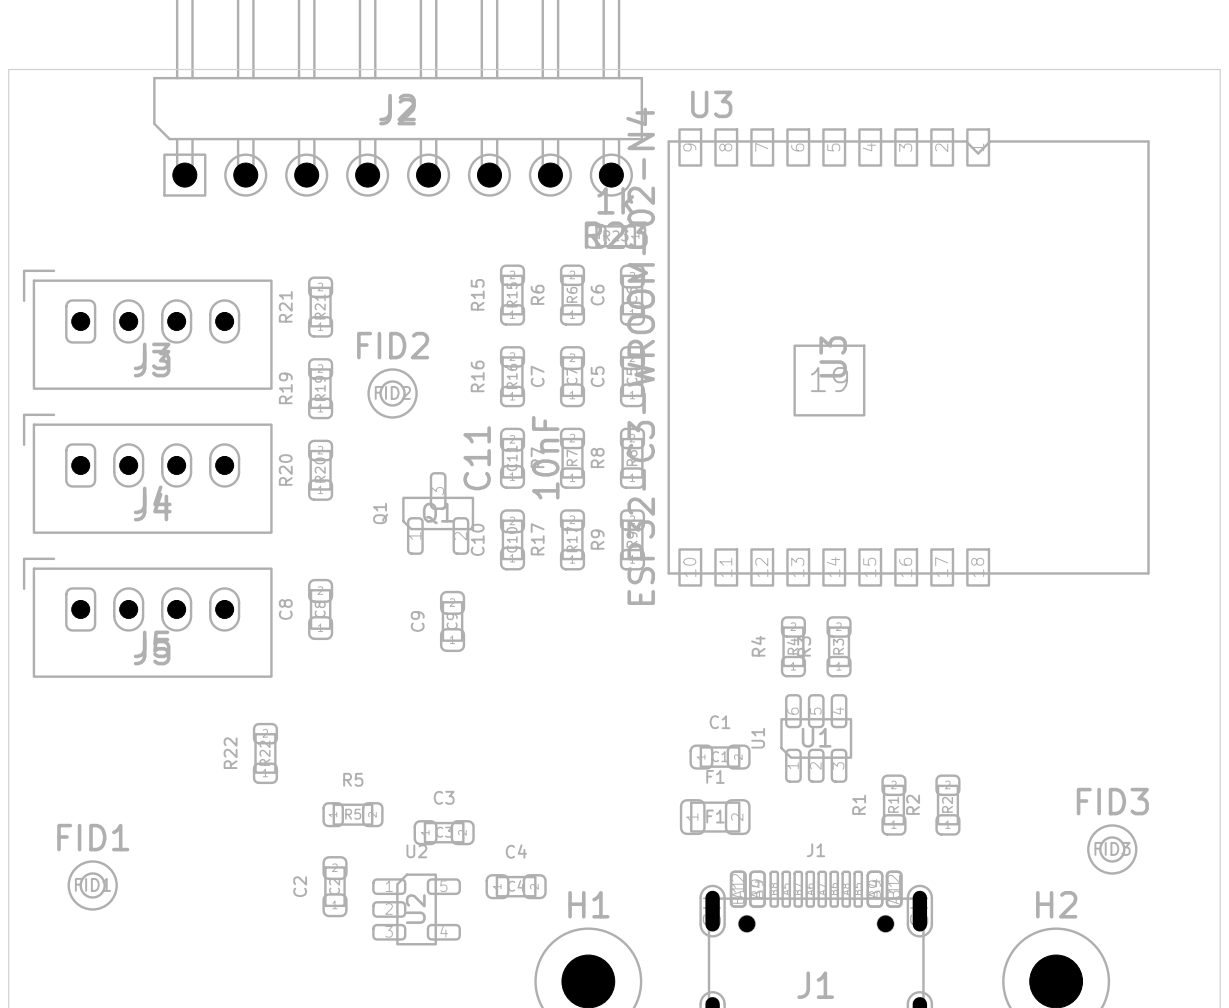
[picture p46: page 1]

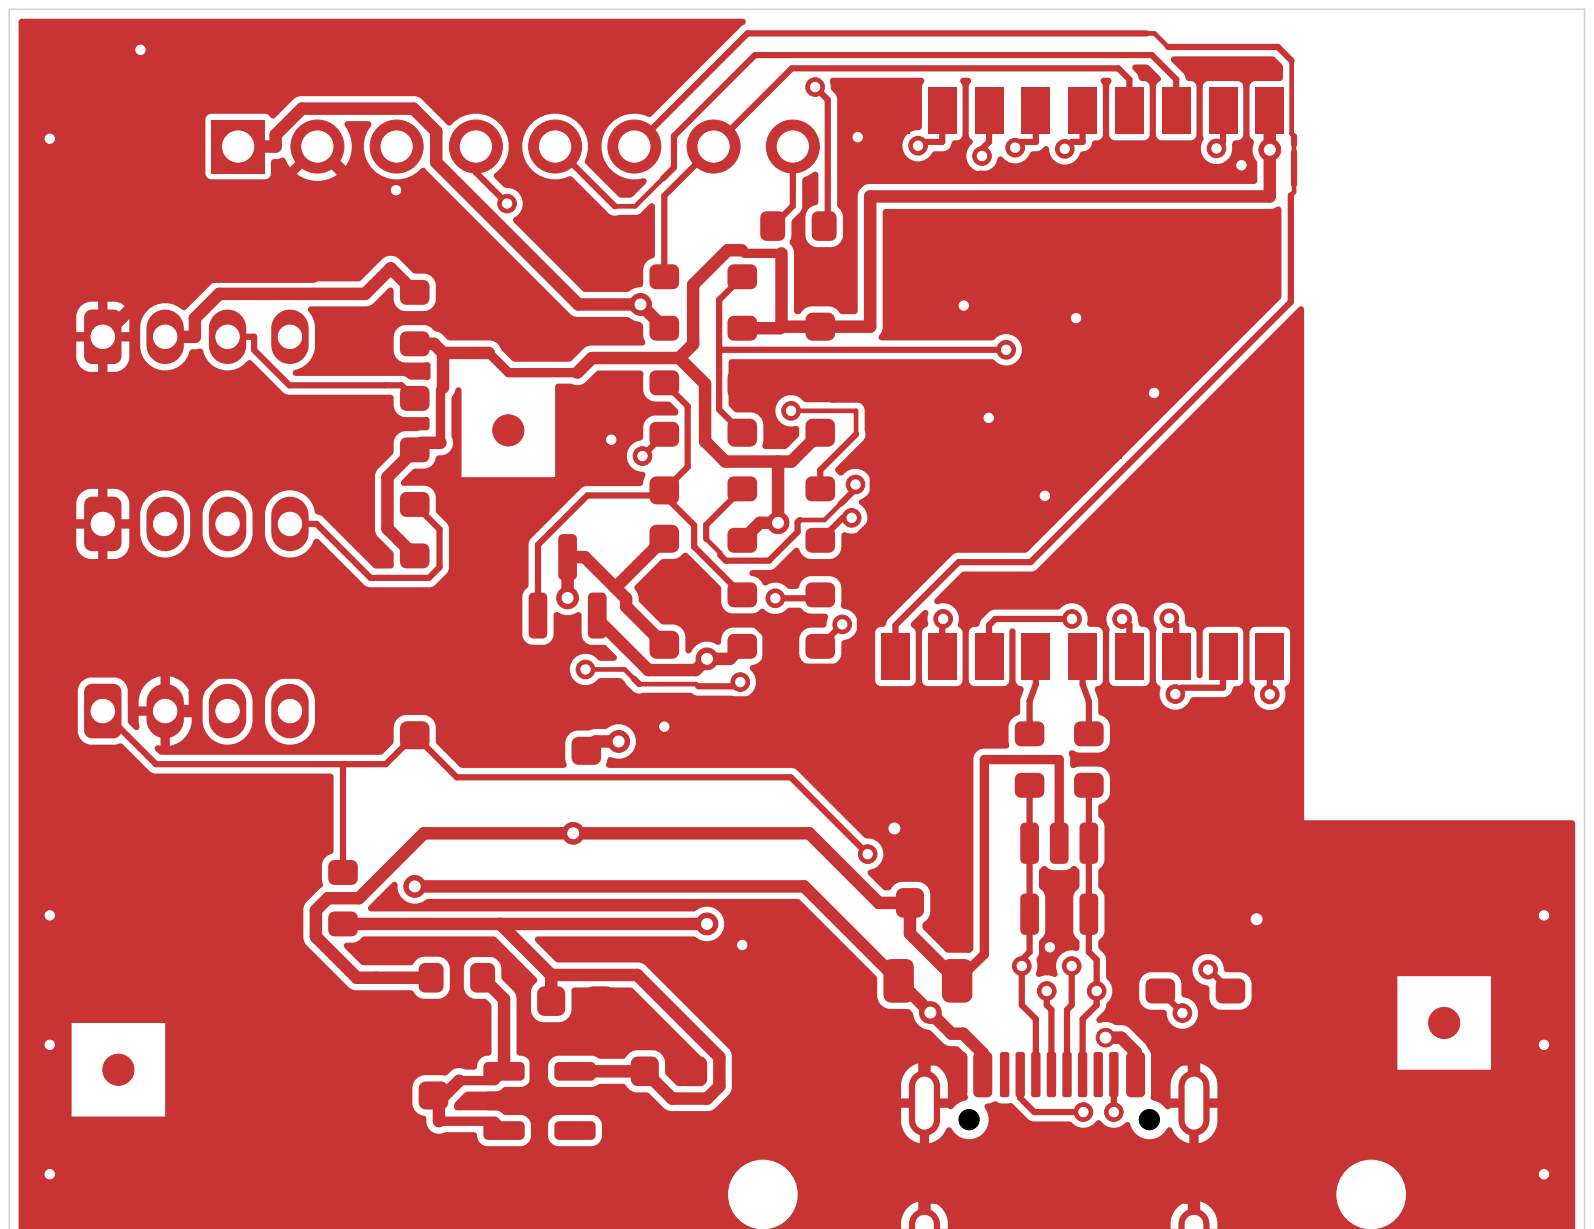
[picture p47: page 2]

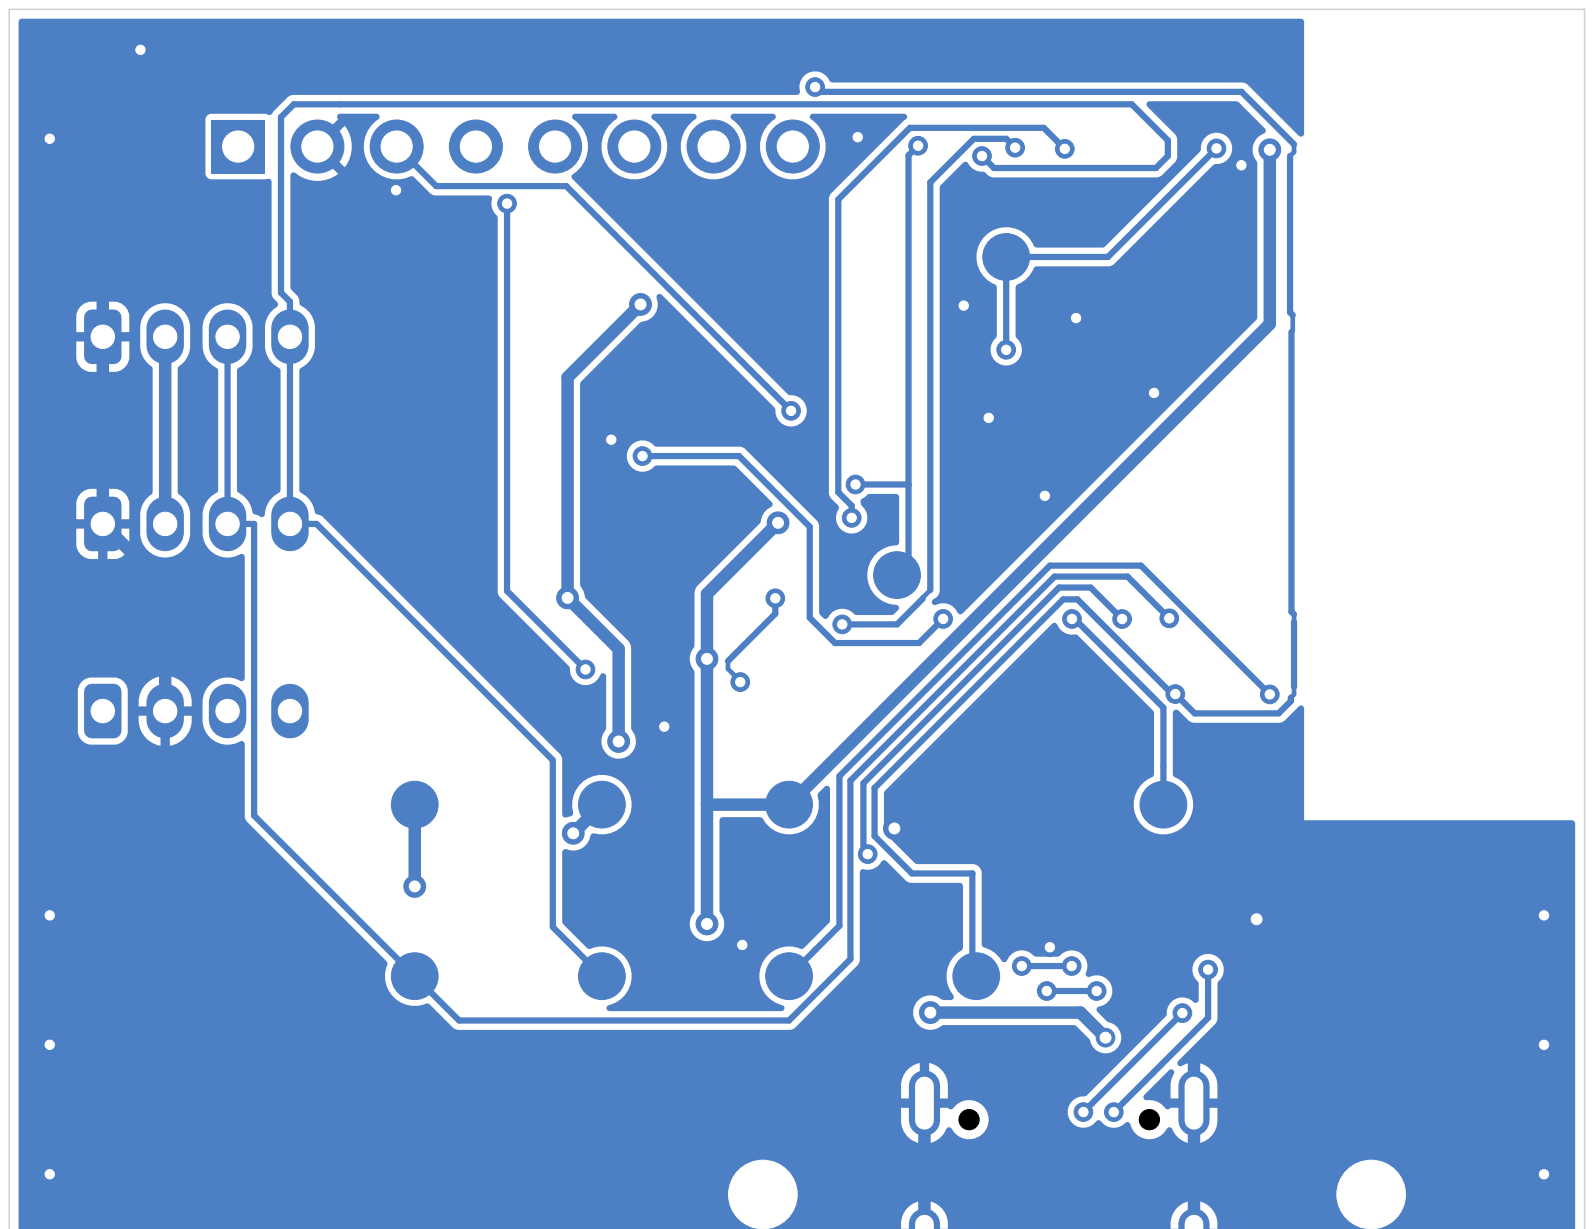
[picture p48: page 3]

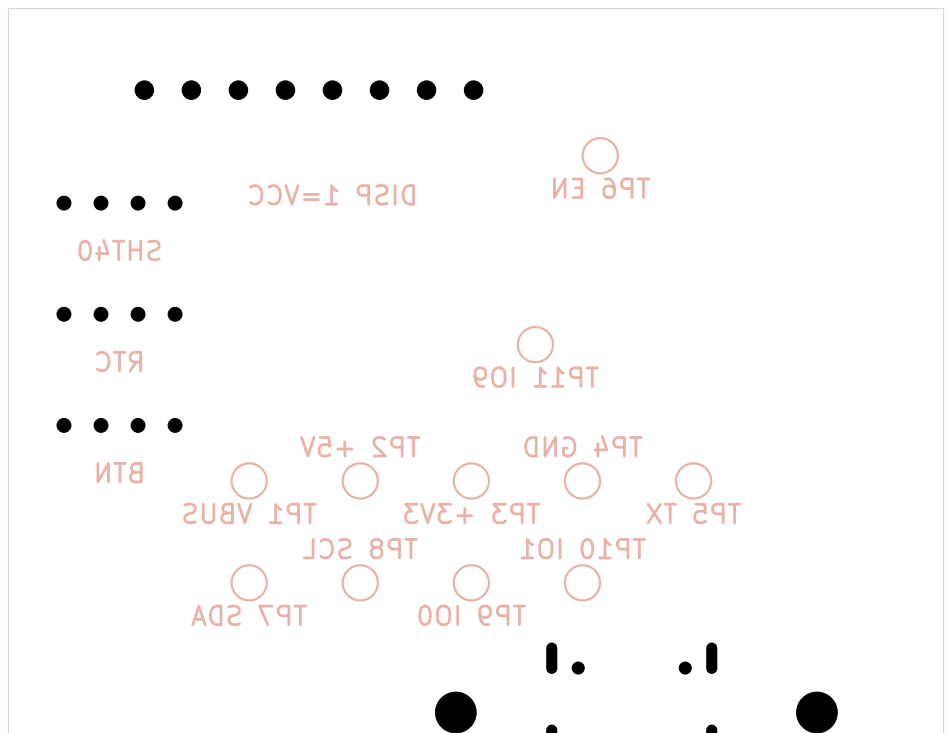
[picture p49: page 4]
