seba379/PoliClock/docs/revisioni/2026-11-08/correzioni/pcb-courtyard.pdf

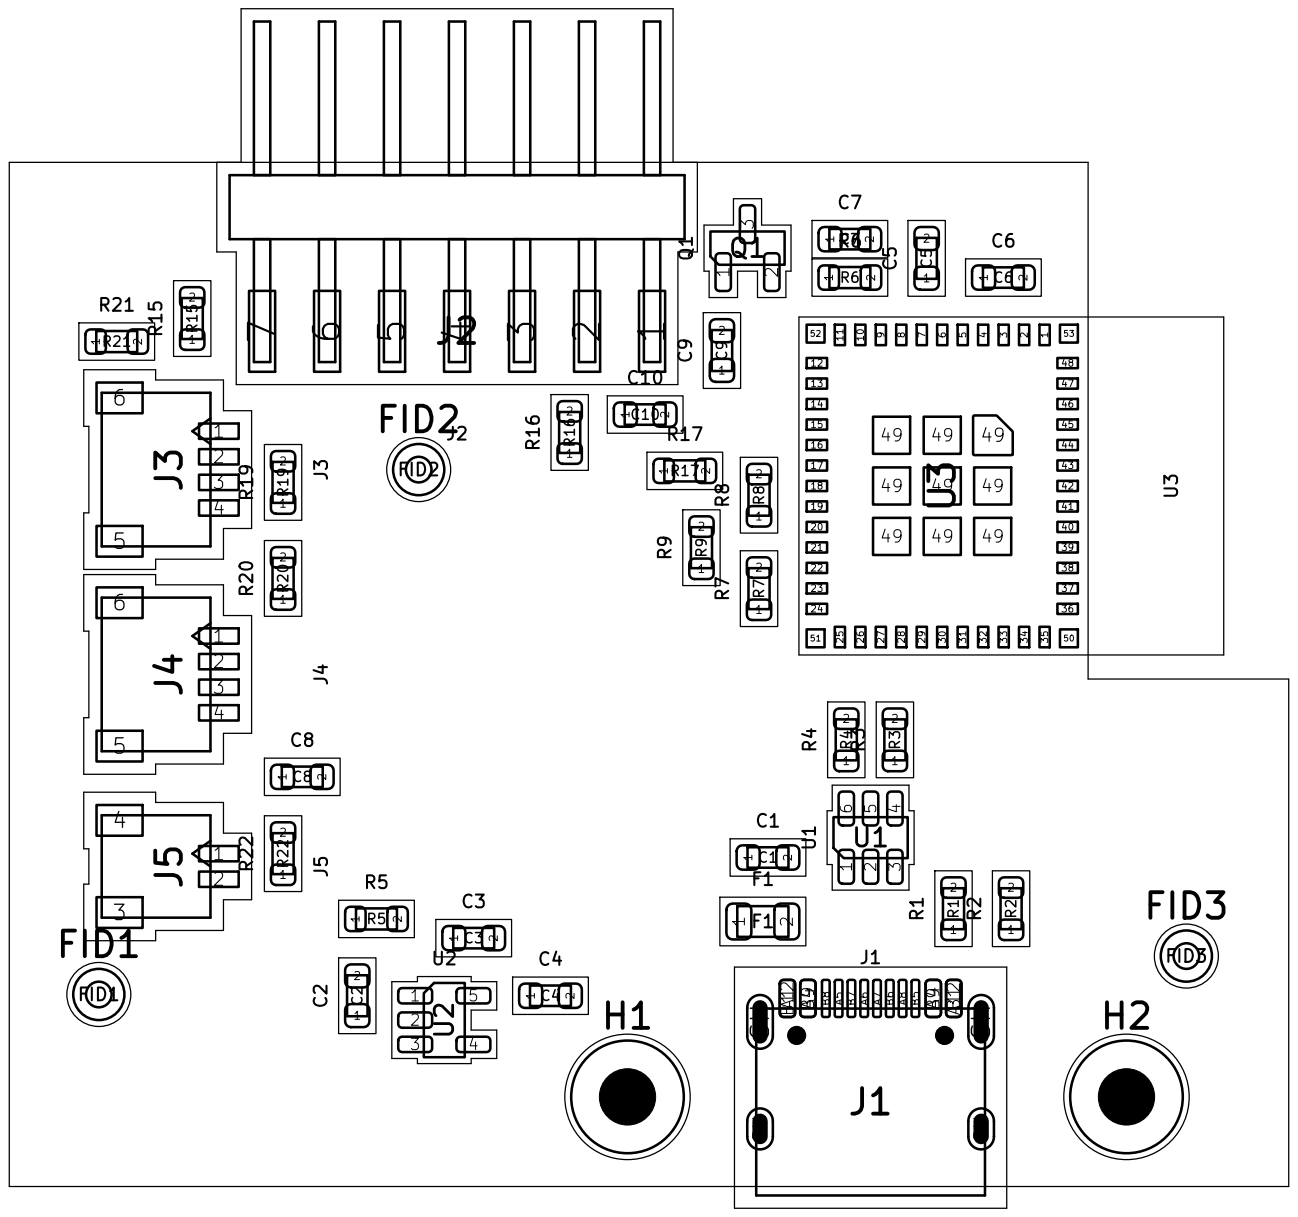
[picture p50: page 1]
