seba379/PoliClock/hardware/policlock-main/policlock-main.kicad_pcb

## KiCad design hardware/policlock-main/policlock-main.kicad_pcb (2026-11-09)

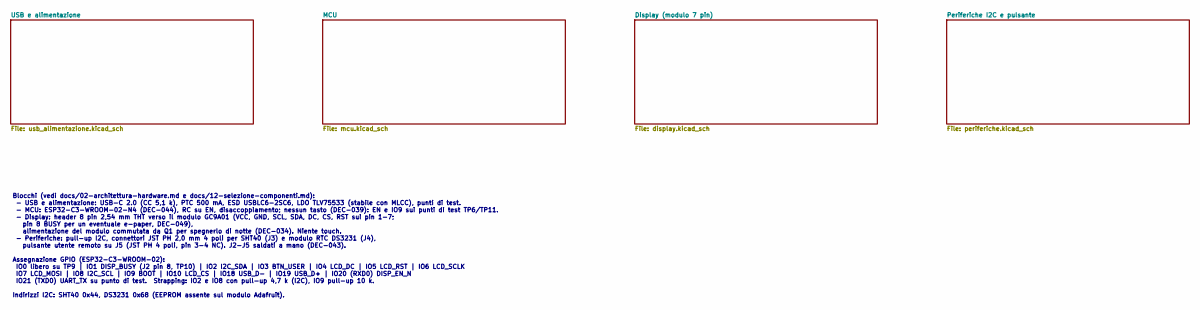
[picture p51: schematic policlock-main.kicad_sch, PoliClock - scheda principale]

Notes on the sheet:
Blocchi (vedi docs/02-architettura-hardware.md e docs/12-selezione-componenti.md): - USB e alimentazione: USB-C 2.0 (CC 5,1 k), PTC 500 mA, ESD USBLC6-2SC6, LDO TLV75533 (stabile con MLCC), punti di test. - MCU: ESP32-C3-WROOM-02-N4 (DEC-044), RC su EN, disaccoppiamento; nessun tasto (DEC-039): EN 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

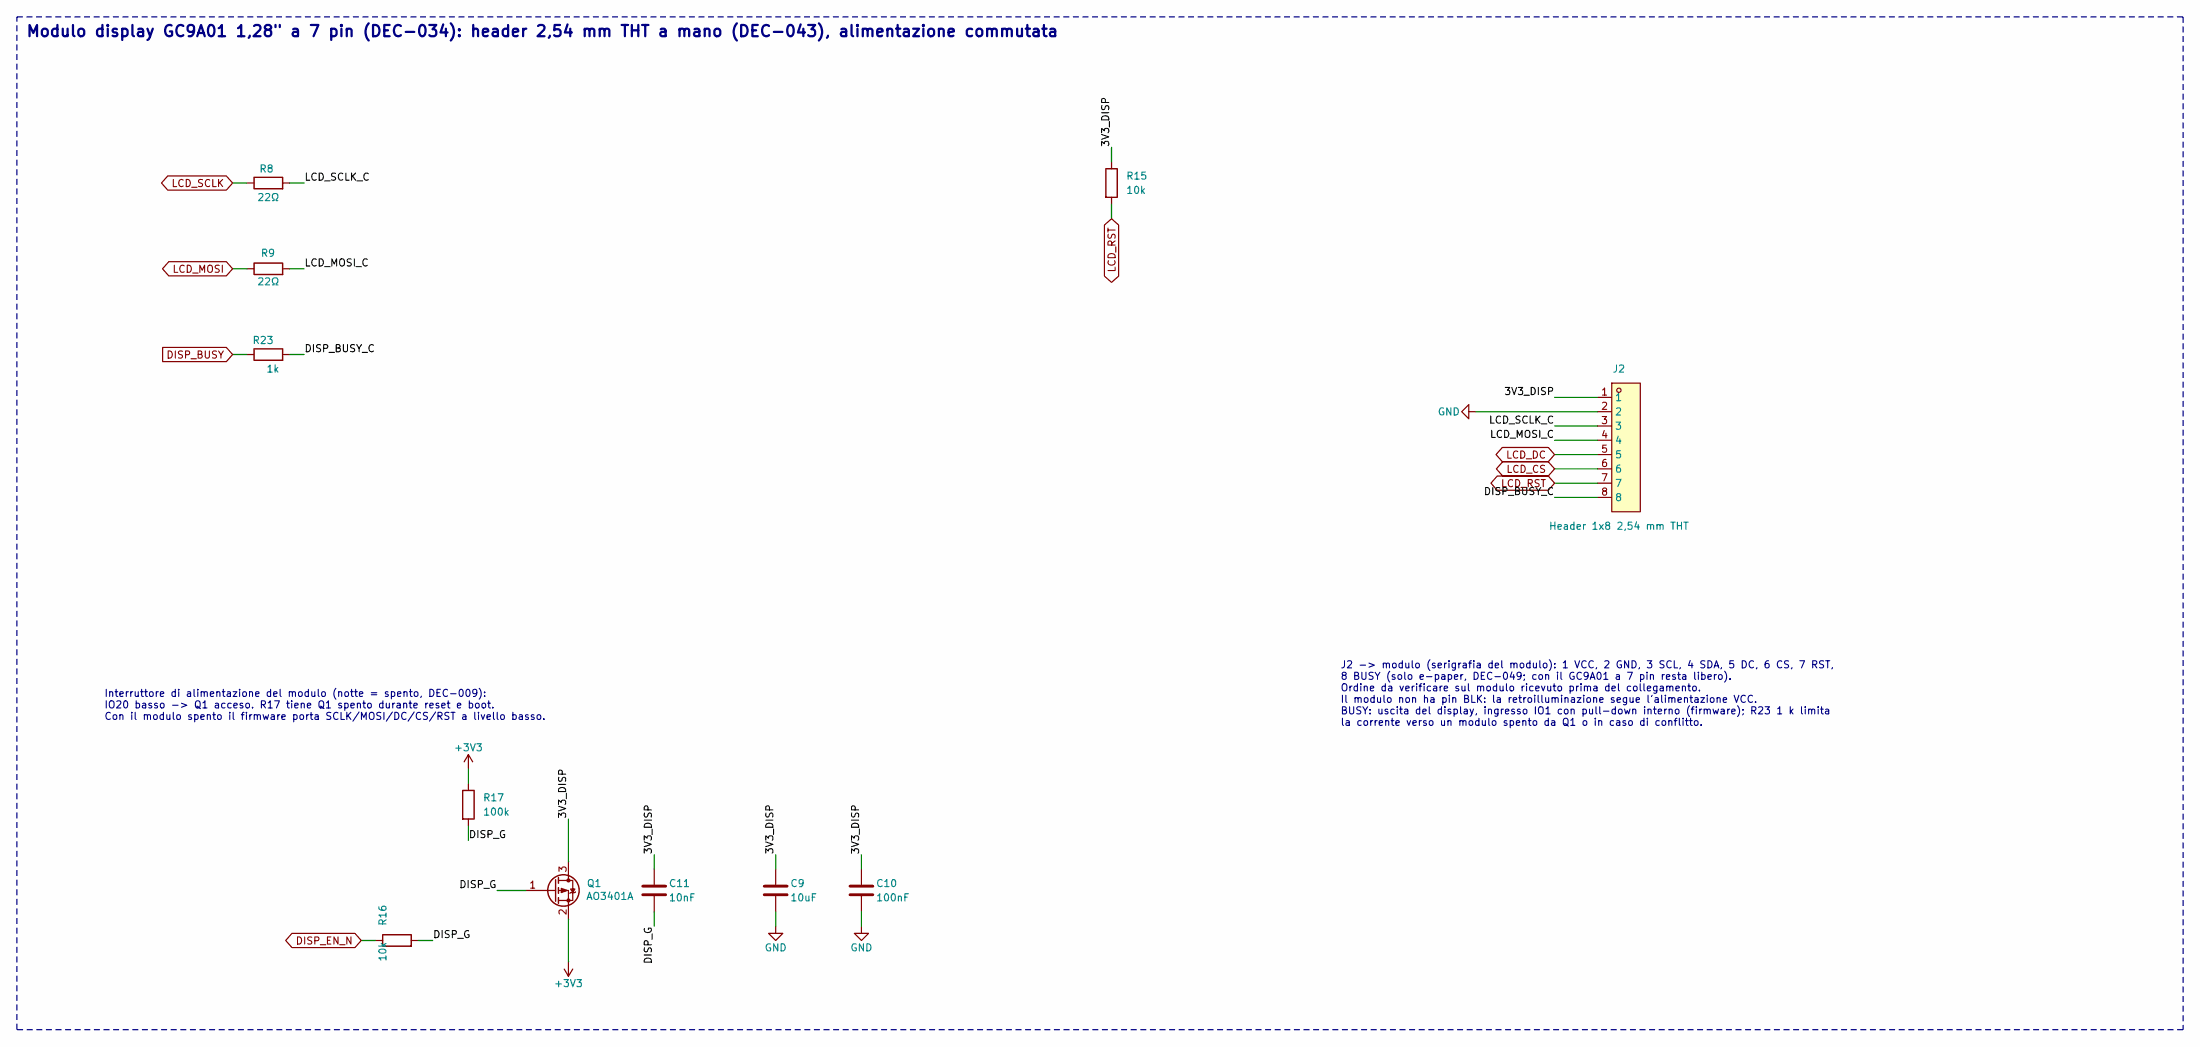
[picture p52: schematic display.kicad_sch, PoliClock main - Display (modulo 7 pin)]

Parts:
C9: 10uF; C_0603_1608Metric; LCSC C19702
C10: 100nF; C_0603_1608Metric; LCSC C14663
C11: 10nF; C_0603_1608Metric; LCSC C57112
J2: Header 1x8 2,54 mm THT; PinHeader_1x08_P2.54mm_Horizontal
Q1: AO3401A; SOT-23; LCSC C15127
R8, R9: 22Ω; R_0603_1608Metric; LCSC C23345
R15, R16: 10k; R_0603_1608Metric; LCSC C25804
R17: 100k; R_0603_1608Metric; LCSC C25803
R23: 1k; R_0603_1608Metric; LCSC C21190

Connections:
+3V3: Q1.2 (S), R17.1; also elsewhere on the board
/Display (modulo 7 pin)/3V3_DISP: C9.1, C10.1, C11.1, J2.1, Q1.3 (D), R15.1
/Display (modulo 7 pin)/DISP_BUSY_C: J2.8, R23.2
/Display (modulo 7 pin)/DISP_G: C11.2, Q1.1 (G), R16.2, R17.2
/Display (modulo 7 pin)/LCD_MOSI_C: J2.4, R9.2
/Display (modulo 7 pin)/LCD_SCLK_C: J2.3, R8.2
DISP_BUSY: R23.1; also elsewhere on the board
DISP_EN_N: R16.1; also elsewhere on the board
GND: C9.2, C10.2, J2.2; also elsewhere on the board
LCD_CS: J2.6; also elsewhere on the board
LCD_DC: J2.5; also elsewhere on the board
LCD_MOSI: R9.1; also elsewhere on the board
LCD_RST: J2.7, R15.2; also elsewhere on the board
LCD_SCLK: R8.1; also elsewhere on the board

Notes on the sheet:
Modulo display GC9A01 1,28" a 7 pin (DEC-034): header 2,54 mm THT a mano (DEC-043), alimentazione commutata
Interruttore di alimentazione del modulo (notte = spento, DEC-009): IO20 basso -> Q1 acceso. R17 tiene Q1 spento durante reset e boot. Con il modulo spento il firmware porta SCLK/MOSI/DC/CS/RST a livello basso.
J2 -> modulo (serigrafia del modulo): 1 VCC, 2 GND, 3 SCL, 4 SDA, 5 DC, 6 CS, 7 RST, 8 BUSY (solo e-paper, DEC-049; con il GC9A01 a 7 pin resta libero). Ordine da verificare sul modulo ricevuto prima del collegamento. Il modulo non ha pin BLK: la retroilluminazione segue l'alimentazione VCC. BUSY: 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

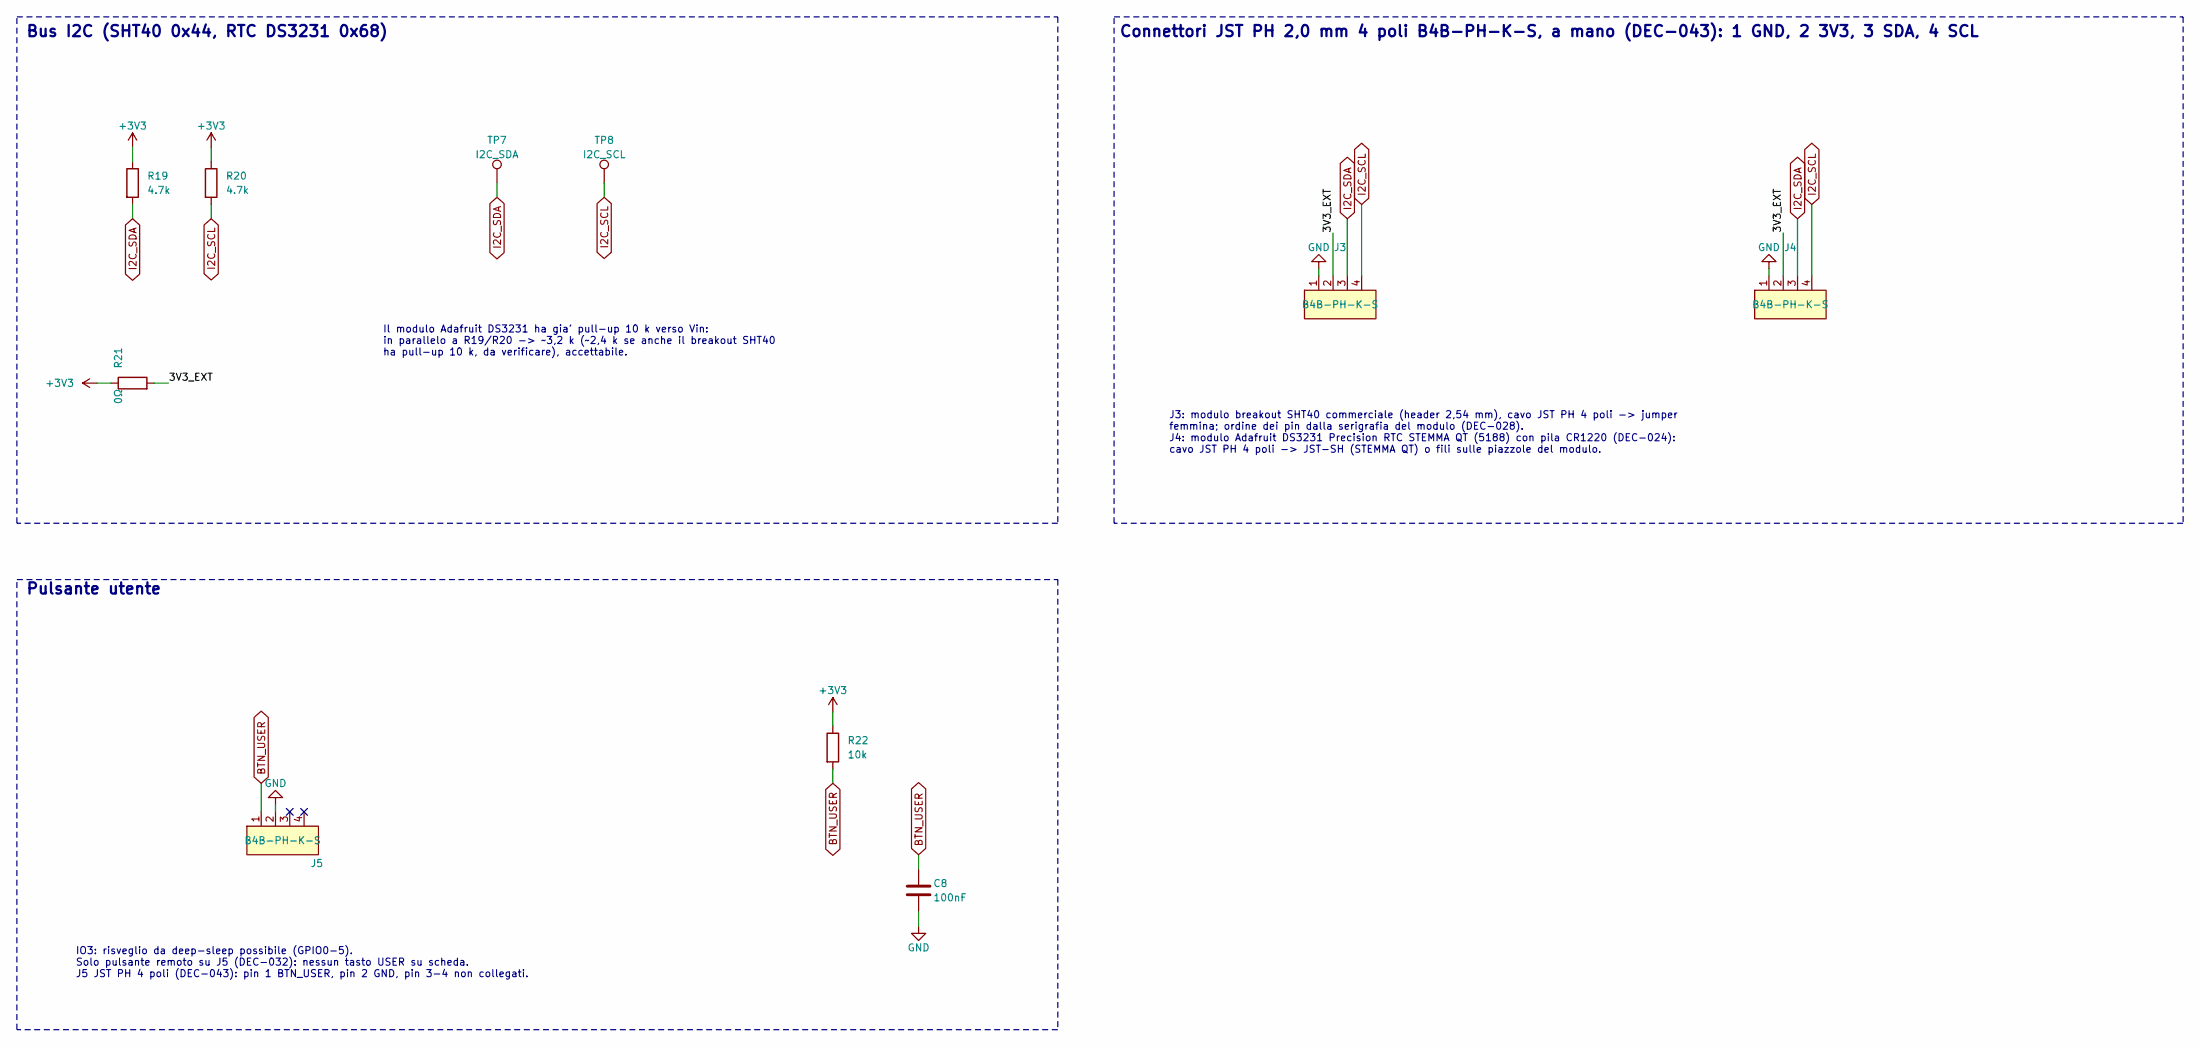
[picture p53: schematic periferiche.kicad_sch, PoliClock main - Periferiche I2C e pulsante]

Parts:
C8: 100nF; C_0603_1608Metric; LCSC C14663
J3, J4, J5: B4B-PH-K-S; JST_PH_B4B-PH-K_1x04_P2.00mm_Vertical
R19, R20: 4.7k; R_0603_1608Metric; LCSC C23162
R21: 0Ω; R_0603_1608Metric; LCSC C21189
R22: 10k; R_0603_1608Metric; LCSC C25804
TP7: I2C_SDA; TestPoint_Pad_D1.5mm
TP8: I2C_SCL; TestPoint_Pad_D1.5mm

Connections:
+3V3: R19.1, R20.1, R21.1, R22.1; also elsewhere on the board
/Periferiche I2C e pulsante/3V3_EXT: J3.2, J4.2, R21.2
BTN_USER: C8.1, J5.1, R22.2; also elsewhere on the board
GND: C8.2, J3.1, J4.1, J5.2; also elsewhere on the board
I2C_SCL: J3.4, J4.4, R20.2, TP8.1; also elsewhere on the board
I2C_SDA: J3.3, J4.3, R19.2, TP7.1; also elsewhere on the board

Notes on the sheet:
Il modulo Adafruit DS3231 ha gia' pull-up 10 k verso Vin: in parallelo a R19/R20 -> ~3,2 k (~2,4 k se anche il breakout SHT40 ha pull-up 10 k, da verificare), accettabile.
Connettori JST PH 2,0 mm 4 poli B4B-PH-K-S, a mano (DEC-043): 1 GND, 2 3V3, 3 SDA, 4 SCL
J3: modulo breakout SHT40 commerciale (header 2,54 mm), cavo JST PH 4 poli -> jumper femmina; ordine dei pin dalla serigrafia del modulo (DEC-028). J4: modulo Adafruit DS3231 Precision RTC STEMMA QT (5188) con pila CR1220 (DEC-024): cavo JST PH 4 poli -> JST-SH (STEMMA QT) o fili sulle piazzole del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
IO3: risveglio da deep-sleep possibile (GPIO0-5). Solo pulsante remoto su J5 (DEC-032): nessun tasto USER su scheda. J5 JST PH 4 poli (DEC-043): pin 1 BTN_USER, pin 2 GND, pin 3-4 non collegati.
Bus I2C (SHT40 0x44, RTC DS3231 0x68)
Pulsante utente

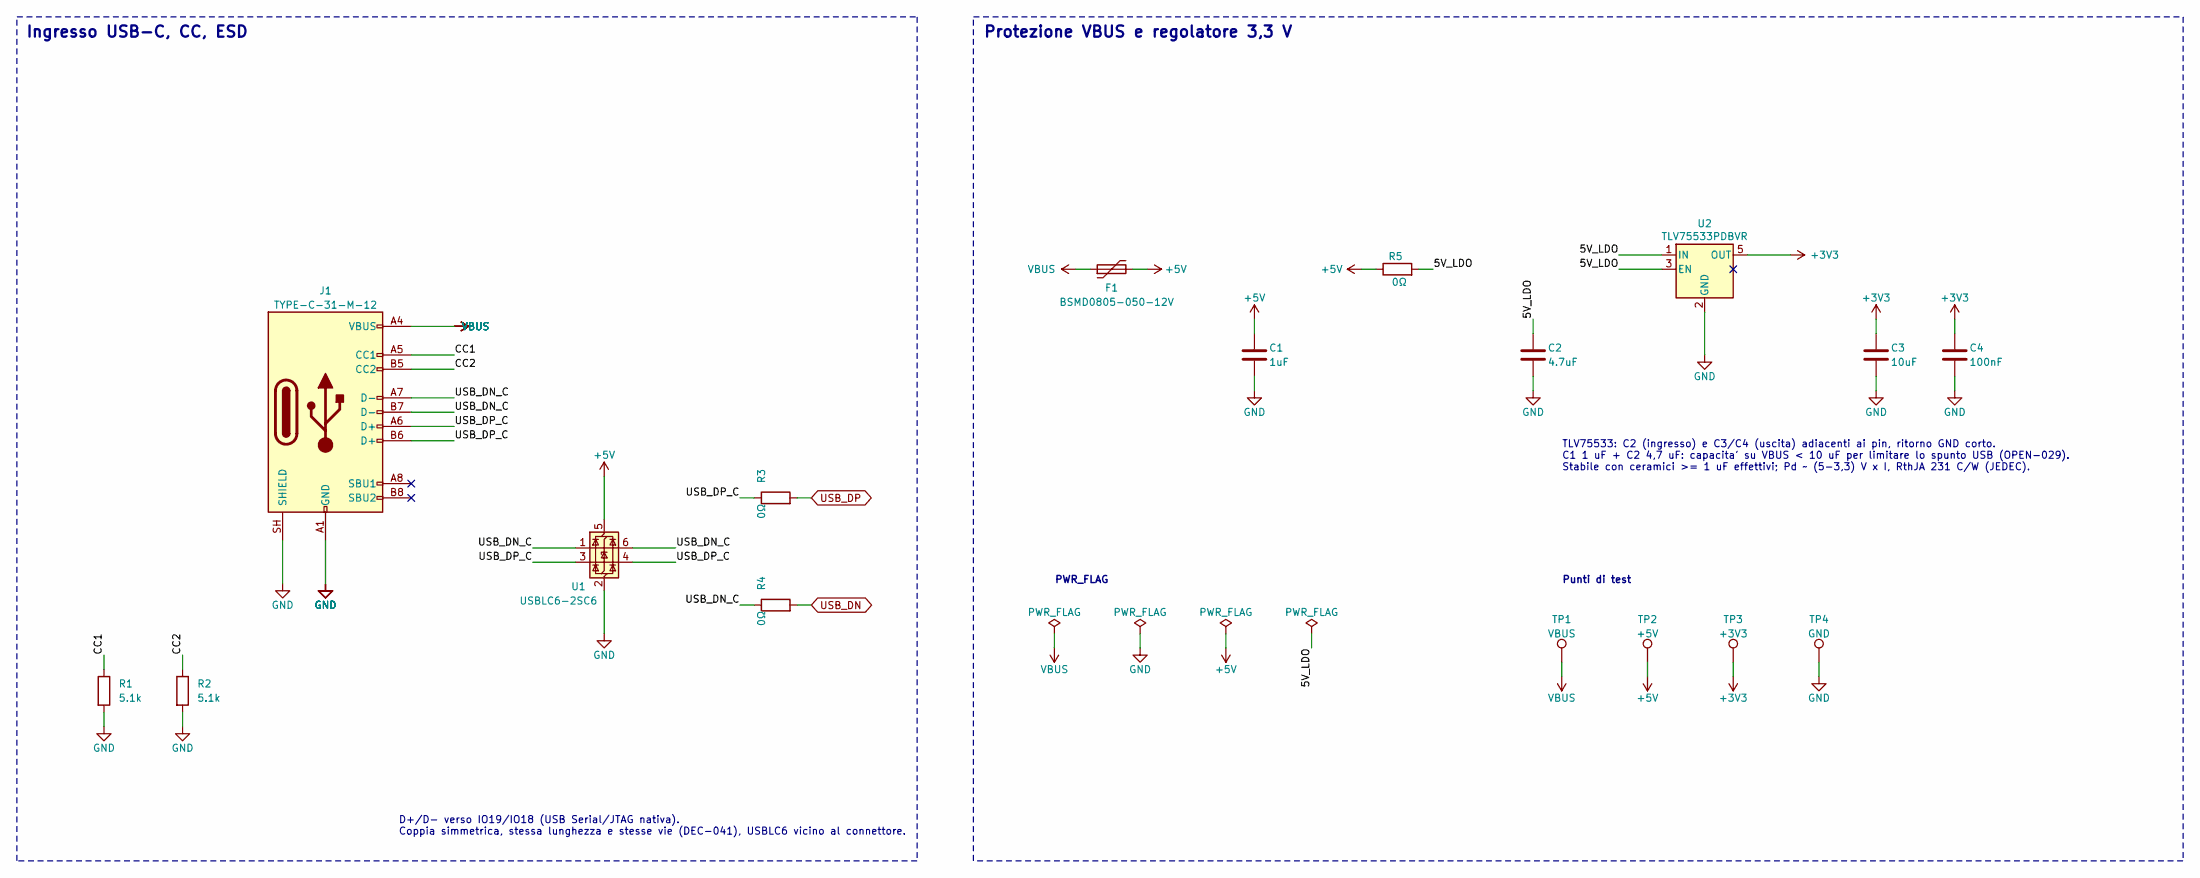
[picture p54: schematic usb_alimentazione.kicad_sch, PoliClock main - USB e alimentazione]

Parts:
C1: 1uF; C_0603_1608Metric; LCSC C15849
C2: 4.7uF; C_0603_1608Metric; LCSC C19666
C3: 10uF; C_0603_1608Metric; LCSC C19702
C4: 100nF; C_0603_1608Metric; LCSC C14663
F1: BSMD0805-050-12V; Fuse_0805_2012Metric; LCSC C2977522
J1: TYPE-C-31-M-12; USB_C_Receptacle_HRO_TYPE-C-31-M-12; LCSC C165948
R1, R2: 5.1k; R_0603_1608Metric; LCSC C23186
R3, R4, R5: 0Ω; R_0603_1608Metric; LCSC C21189
TP1: VBUS; TestPoint_Pad_D1.5mm
TP2: +5V; TestPoint_Pad_D1.5mm
TP3: +3V3; TestPoint_Pad_D1.5mm
TP4: GND; TestPoint_Pad_D1.5mm
U1: USBLC6-2SC6; SOT-23-6; LCSC C7519
U2: TLV75533PDBVR; SOT-23-5; LCSC C404027

Connections:
+3V3: C3.1, C4.1, TP3.1, U2.5 (OUT); also elsewhere on the board
+5V: C1.1, F1.2, R5.1, TP2.1, U1.5 (VBUS)
/USB e alimentazione/5V_LDO: C2.1, R5.2, U2.1 (IN), U2.3 (EN)
/USB e alimentazione/CC1: J1.A5 (CC1), R1.1
/USB e alimentazione/CC2: J1.B5 (CC2), R2.1
/USB e alimentazione/USB_DN_C: J1.A7 (D-), J1.B7 (D-), R4.1, U1.1 (I/O1), U1.6 (I/O1)
/USB e alimentazione/USB_DP_C: J1.A6 (D+), J1.B6 (D+), R3.1, U1.3 (I/O2), U1.4 (I/O2)
GND: C1.2, C2.2, C3.2, C4.2, J1.A1 (GND), J1.A12 (GND), J1.B1 (GND), J1.B12 (GND), J1.SH (SHIELD), R1.2, R2.2, TP4.1, U1.2 (GND), U2.2 (GND); also elsewhere on the board
USB_DN: R4.2; also elsewhere on the board
USB_DP: R3.2; also elsewhere on the board
VBUS: F1.1, J1.A4 (VBUS), J1.A9 (VBUS), J1.B4 (VBUS), J1.B9 (VBUS), TP1.1

Notes on the sheet:
Ingresso USB-C, CC, ESD
PWR_FLAG
D+/D- verso IO19/IO18 (USB Serial/JTAG nativa). Coppia simmetrica, stessa lunghezza e stesse vie (DEC-041), USBLC6 vicino al connettore.
TLV75533: C2 (ingresso) e C3/C4 (uscita) adiacenti ai pin, ritorno GND corto. C1 1 uF + C2 4,7 uF: capacita' su VBUS < 10 uF per limitare lo spunto USB (OPEN-029). Stabile con ceramici >= 1 uF effettivi; Pd ~ (5-3,3) V x I, RthJA 231 C/W (JEDEC).
Protezione VBUS e regolatore 3,3 V
Punti di test

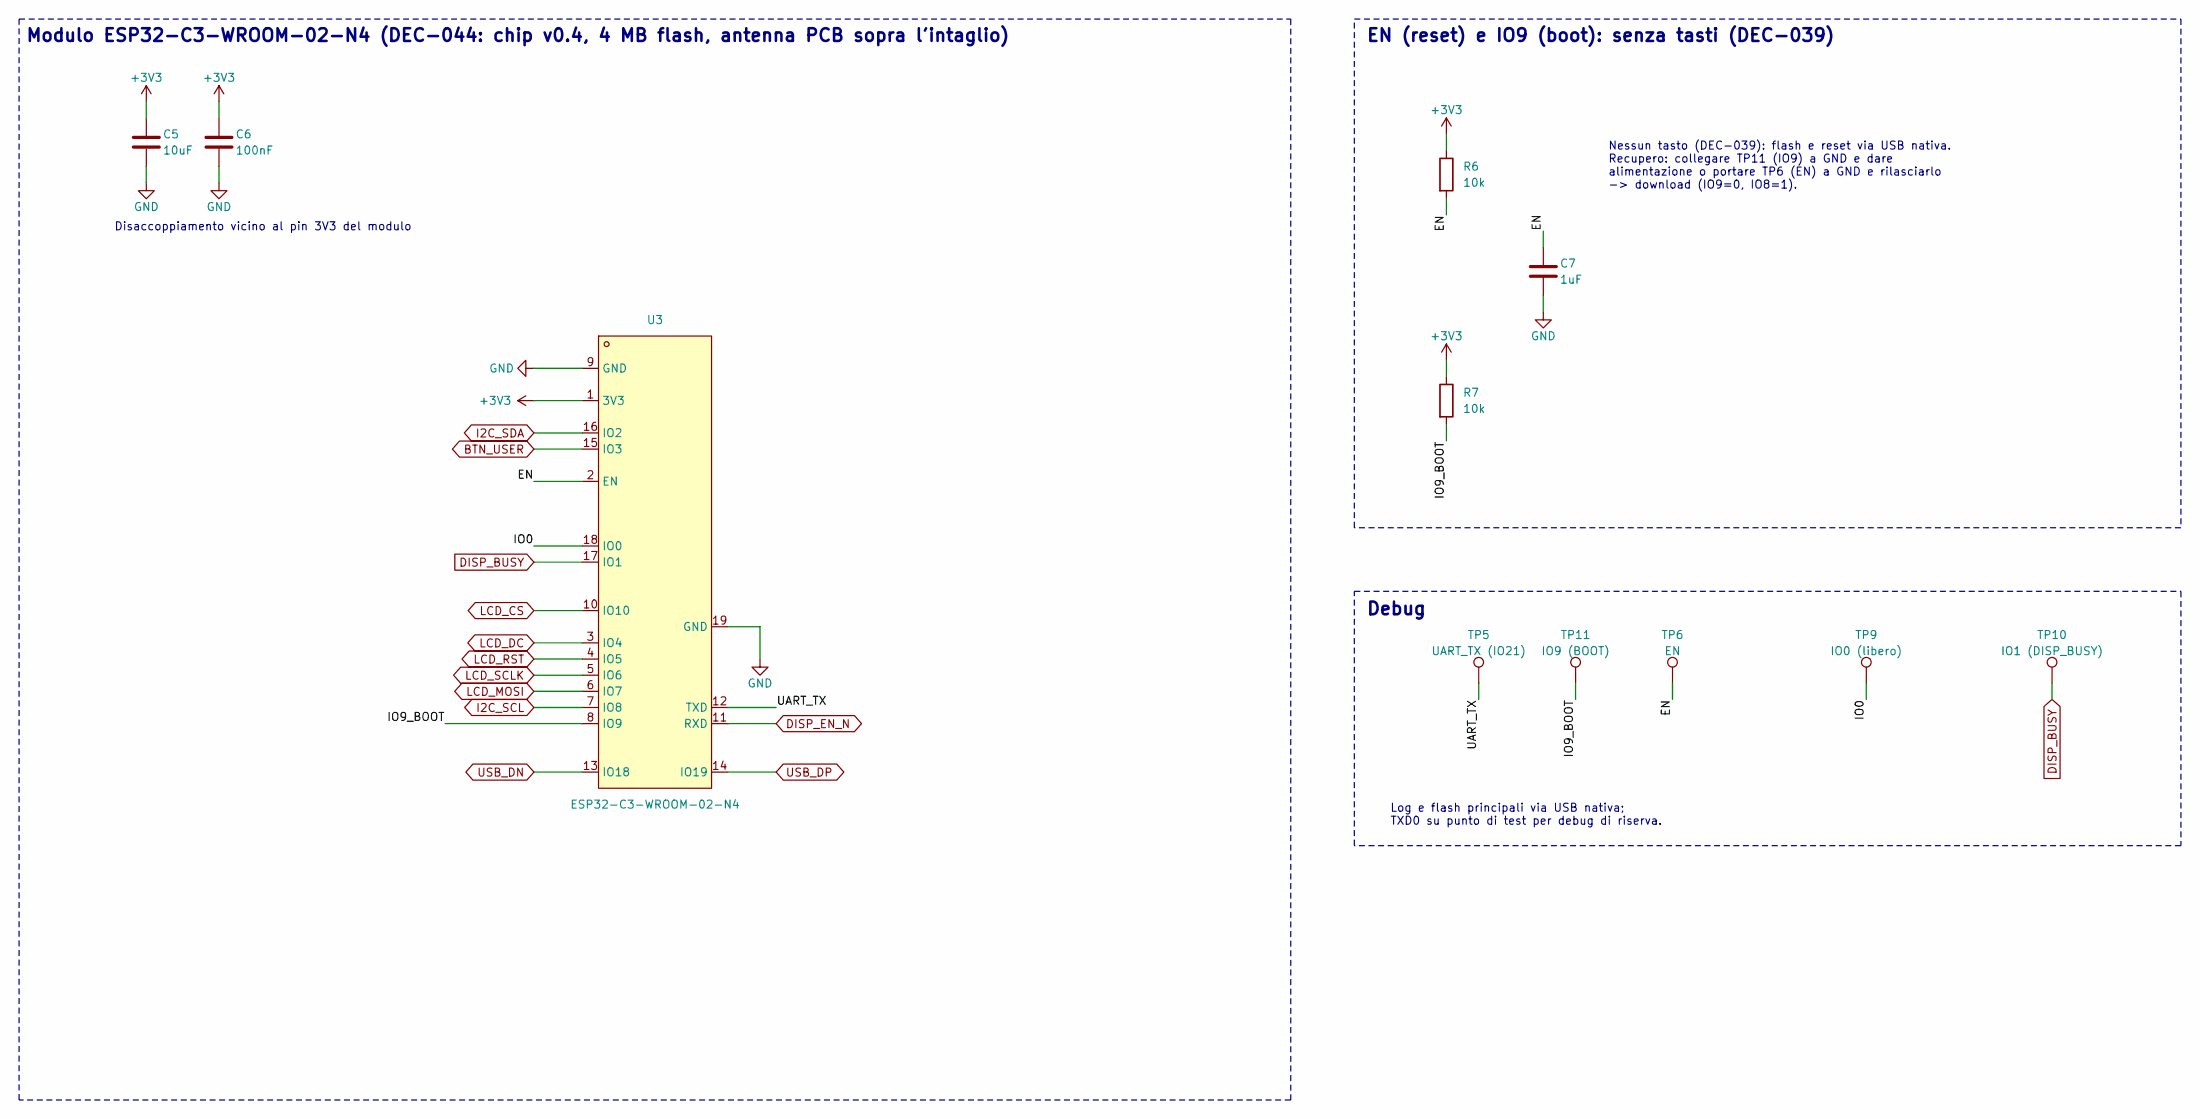
[picture p55: schematic mcu.kicad_sch, PoliClock main - MCU]

Parts:
C5: 10uF; C_0603_1608Metric; LCSC C19702
C6: 100nF; C_0603_1608Metric; LCSC C14663
C7: 1uF; C_0603_1608Metric; LCSC C15849
R6, R7: 10k; R_0603_1608Metric; LCSC C25804
TP5: UART_TX (IO21); TestPoint_Pad_D1.5mm
TP6: EN; TestPoint_Pad_D1.5mm
TP9: IO0 (libero); TestPoint_Pad_D1.5mm
TP10: IO1 (DISP_BUSY); TestPoint_Pad_D1.5mm
TP11: IO9 (BOOT); TestPoint_Pad_D1.5mm
U3: ESP32-C3-WROOM-02-N4; ESP32-C3-WROOM-02; LCSC C2934560

Connections:
+3V3: C5.1, C6.1, R6.1, R7.1, U3.1 (3V3); also elsewhere on the board
/MCU/EN: C7.1, R6.2, TP6.1, U3.2 (EN)
/MCU/IO0: TP9.1, U3.18 (IO0)
/MCU/IO9_BOOT: R7.2, TP11.1, U3.8 (IO9)
/MCU/UART_TX: TP5.1, U3.12 (TXD)
BTN_USER: U3.15 (IO3); also elsewhere on the board
DISP_BUSY: TP10.1, U3.17 (IO1); also elsewhere on the board
DISP_EN_N: U3.11 (RXD); also elsewhere on the board
GND: C5.2, C6.2, C7.2, U3.9 (GND), U3.19 (GND); also elsewhere on the board
I2C_SCL: U3.7 (IO8); also elsewhere on the board
I2C_SDA: U3.16 (IO2); also elsewhere on the board
LCD_CS: U3.10 (IO10); also elsewhere on the board
LCD_DC: U3.3 (IO4); also elsewhere on the board
LCD_MOSI: U3.6 (IO7); also elsewhere on the board
LCD_RST: U3.4 (IO5); also elsewhere on the board
LCD_SCLK: U3.5 (IO6); also elsewhere on the board
USB_DN: U3.13 (IO18); also elsewhere on the board
USB_DP: U3.14 (IO19); also elsewhere on the board

Notes on the sheet:
Disaccoppiamento vicino al pin 3V3 del modulo
EN (reset) e IO9 (boot): senza tasti (DEC-039)
Modulo ESP32-C3-WROOM-02-N4 (DEC-044: chip v0.4, 4 MB flash, antenna PCB sopra l'intaglio)
Nessun tasto (DEC-039): flash e reset via USB nativa. Recupero: collegare TP11 (IO9) a GND e dare alimentazione o portare TP6 (EN) a GND e rilasciarlo -> download (IO9=0, IO8=1).
Debug
Log e flash principali via USB nativa; TXD0 su punto di test per debug di riserva.

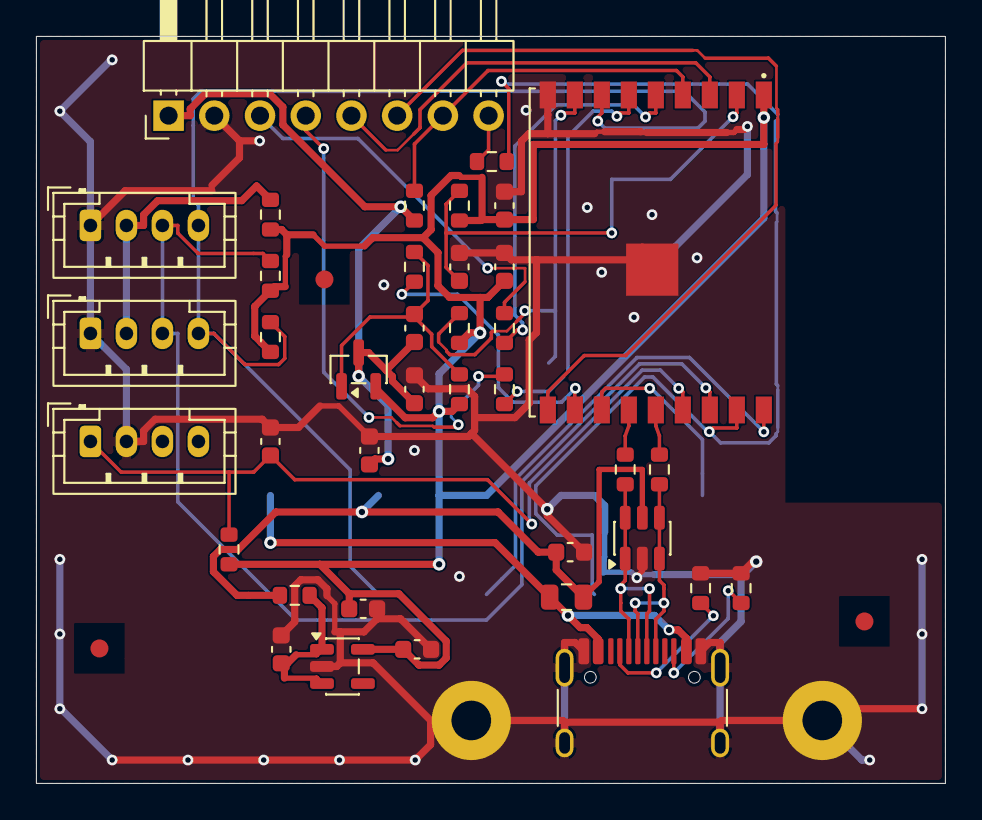
[picture p56: board policlock-main.kicad_pcb from above]

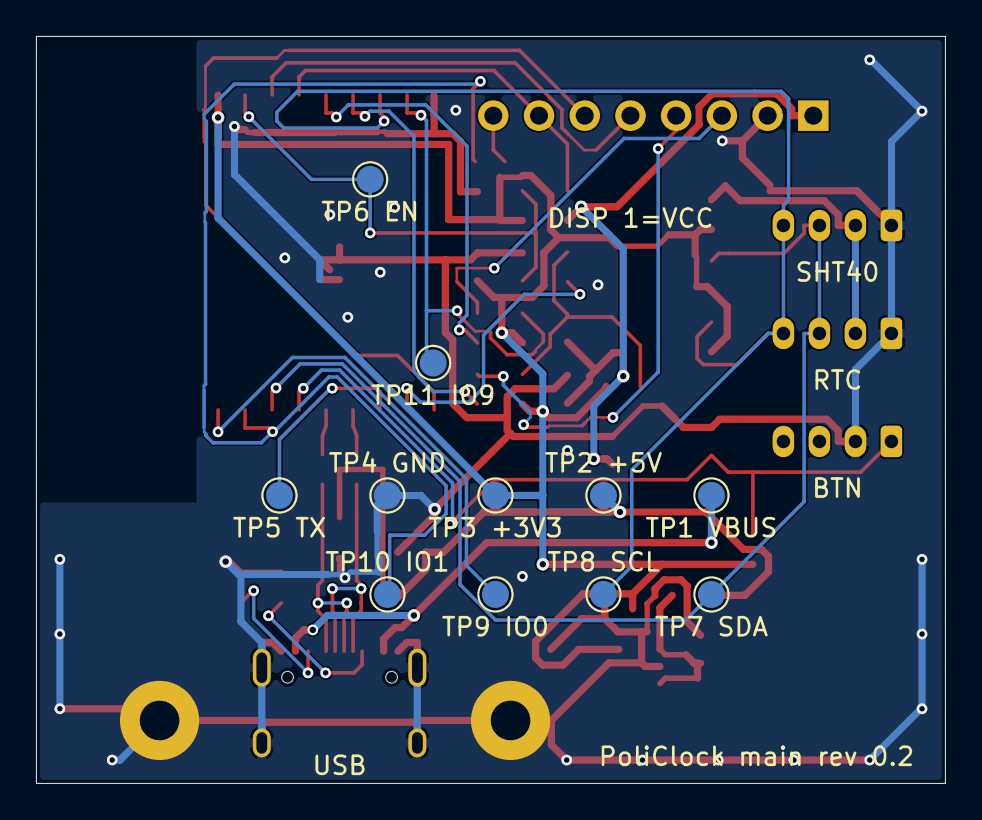
[picture p57: board policlock-main.kicad_pcb from below]

Board: 2 copper layers, 50.5 x 41.5 mm, 54 parts (11 on the bottom side), 31 nets.

Other parts of the board:
FID1, FID2, FID3: Fiducial; Fiducial_1mm_Mask2mm
H1, H2: M2; MountingHole_2.2mm_M2_Pad

Their connections:
GND: H1.1, H2.1; also elsewhere on the board
