seba379/PoliClock/(commit log)

2026-11-07 docs: integrate owner decisions and spec review findings (v0.2)
    - Record DEC-008..012: 48 h recharge cadence accepted, night mode with
    display off, blue uniform and cap, USB-C confirmed, Wi-Fi/NTP removed.
    - Add schematic findings: I2C on GPIO14/15, header H2 pinout, AXP2101 TS
    on board thermistor (not cell), RTC without dedicated backup.
    - Separate display FSM from UI flags, add NIGHT/NIGHT_PEEK, make burn-in
    pixel shift mandatory, define autonomy usage profile.
2026-11-07 docs: switch to custom PCB architecture with round IPS display (v0.3)
    - Record DEC-015..018: custom KiCad PCB assembled by JLCPCB (Waveshare
    board dropped), 1.28in GC9A01 IPS display, physical button instead of
    touch, USB-C panel extension on the lower back.
    - Rewrite hardware, power, BOM and roadmap for the custom PCB: bench
    prototype first, charger with power-path and cell NTC, external RTC
    with backup supply, new PCB design and bring-up milestones and tests.
    - Align requirements, firmware, UI, mechanics and sources; drop AMOLED
    burn-in requirement; bump all specs to v0.3.
2026-11-07 docs: add touch predisposition and USB PC configurator (DEC-019, DEC-020)
    - Reserve touch connector, INT/RST GPIOs and unpopulated parts on the PCB;
    pick a panel available with and without touch; test touch module in M1.
    - Make the USB PC configurator the main way to set time and night window,
    with a versioned line protocol and a Web Serial page; button menu stays
    as fallback.
2026-11-07 docs: split main PCB from display and record toolchain (v0.4)
    - DEC-021: rectangular main board separate from the display, round
    display carrier in the head linked by an FFC/JST-SH cable through the
    neck, SHT40 mini board; main board location (body/base with on-board
    USB-C preferred, or head with extension) decided by a Blender blockout.
    - DEC-022: KiCad 10 with kicad-cli, VS Code + ESP-IDF v6.x, Blender for
    the character, build123d for internal technical parts.
    - Update power, mechanics, BOM, roadmap, tests (VT-PCB-003), README,
    AGENTS and sources accordingly; bump specs to v0.4.
2026-11-07 docs: drop the battery from V1, USB-powered only (v0.5)
    - DEC-023: V1 runs from a always-connected USB-C cable; external RTC with
    backup is kept so time survives unplugging. Battery deferred to future
    versions. Supersedes DEC-005, DEC-008, DEC-014.
    - Remove cell, charger, NTC, battery gauge, autonomy target and their
    tests/BOM items; rewrite power spec around USB input protection, LDO,
    RTC backup, heat and unplug robustness; reassign VT-PWR tests.
    - Firmware/UI: drop battery states and indicators, light-sleep optional.
    - Mechanics: ballast in the base and guided cable exit for stability.
    - Add standalone concept SVGs (product and block diagram) and link them
    from README and the arc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
2026-11-07 hardware: KiCad schematic rev 0.1 for main, display and SHT40 boards (v0.6)
    - Three KiCad 10 projects in hardware/ (main board hierarchical: USB/power,
    MCU, display FFC, I2C peripherals; display carrier; SHT40 mini-PCB),
    every assembled part with LCSC code; ERC clean (0 violations, all
    severities), PDF and JLCPCB BOM exported.
    - Project library imported with easyeda2kicad and corrected (pin types,
    LCSC field, SHT40 die pad removed per Sensirion datasheet V7.3).
    - Owner decisions: external Adafruit DS3231 STEMMA QT RTC (RV-3028-C7 out
    of stock), touch 18-pin panel, 16-pin 0.5 mm FFC cable, button connector
    plus on-board switch (DEC-024..027).
    - New docs/12 component selection and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
    [display.kicad_sch, mcu.kicad_sch, periferiche.kicad_sch, policlock-display-bom-completa.csv, policlock-display-bom-jlcpcb.csv, policlock-display.kicad_sch, policlock-main-bom-completa.csv, policlock-main-bom-jlcpcb.csv]
2026-11-07 hardware: replace SHT40 mini-PCB with a commercial breakout (DEC-028)
    - Owner decision: SHT40 on an off-the-shelf breakout module wired to J3
    (JST-SH 4P to female jumper), powered at 3.3 V; LED removed if present.
    - Removed the policlock-sht40 KiCad project and the SHT40 symbol and
    footprint from the project library; scripts updated; main schematic
    note on J3 updated, ERC still clean.
    - Docs updated: requirements, architecture, BOM, roadmap, mechanics,
    decision log (DEC-028, CAND-002 superseded, OPEN-002), component
    selection.
    [periferiche.kicad_sch, policlock-main-bom-completa.csv, policlock-sht40-bom-completa.csv, policlock-sht40-bom-jlcpcb.csv, policlock-sht40.kicad_sch]
2026-11-07 hardware: first placement of the main board PCB (35 x 27 mm)
    - policlock-main.kicad_pcb: 2 layers, components on top only, ESP32-C3
    module antenna beyond the right edge, USB-C flush on the bottom edge with
    two M2 holes beside it, FFC on the top edge, JST-SH on the left edge,
    test points as bare pads on the back; GND pours on both layers.
    - Placement only: DRC (kicad-cli, all severities) has no errors besides
    the 83 unrouted connections and 8 silkscreen-at-edge warnings.
    - RESET/BOOT switches now 4x3 mm TS-1088 (C720477, Basic); USB-C
    footprint pegs made NPTH with 0.1 mm local pad clearance.
    - Exports: top/bottom renders, layout PDF, board-only STEP (full STEP with
    EasyEDA models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
    [display.kicad_sch, mcu.kicad_sch, periferiche.kicad_sch, policlock-main-bom-completa.csv, policlock-main-bom-jlcpcb.csv, policlock-main-scheda.step, policlock-main.kicad_pcb]
2026-11-07 hardware: remove on-board USER switch, main board now 35 x 26 mm (DEC-032)
    - Owner decision: the user button is only the remote one on J5; SW3 and
    its TS-1187A symbol/footprint removed from schematic and library.
    - PCB placement regenerated at 35 x 26 mm (was 35 x 27): DRC has no errors
    besides 81 unrouted connections, only silkscreen warnings; renders,
    layout PDF, STEP and BOMs re-exported, ERC clean.
    - Docs 02, 06, 08, 09, 10, 11, 12 and hardware README updated.
    [periferiche.kicad_sch, policlock-main-bom-completa.csv, policlock-main-bom-jlcpcb.csv, policlock-main-scheda.step, policlock-main.kicad_pcb, policlock-main.kicad_sch]
2026-11-07 hardware: route the main board with Freerouting, 40 x 30 mm (DEC-033)
    - Owner accepted a larger board for reliable routing: 35x26 left 10
    unrouted nets, 38x28 could not fit the spaced passives, 40x30 and
    42x32 route completely; 40x30 kept.
    - Placer adds 0.6 mm spacing; sbroglia_main.py exports DSN, runs
    Freerouting 2.5.0 (jar, portable Java 25), imports SES, refills GND
    pours; Power netclass 0.4 mm, signals 0.2 mm, 59 vias, 0.45 mm edge
    keepout for tracks/vias.
    - DRC (kicad-cli, all severities): 0 errors, 0 unconnected, 10 silkscreen
    warnings. Renders, layout PDF, board STEP re-exported.
    - Docs 02, 06, 08, 09, 10, 11 and hardware README updated (DEC-033,
    OPEN-027 now a review i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
    [policlock-main-scheda.step, policlock-main.kicad_pcb]
2026-11-08 docs: add JLCPCB fabrication and assembly constraint (SC-008)
2026-11-08 hardware: rev 0.2 main board 50 x 40 mm, JLC rules, no RESET/BOOT switches
    - Schematic rev 0.2 after the independent technical review: ESP32-C3-MINI-1-H4X,
    TLV75533 LDO, 7-pin GC9A01 display module with AO3401A power switch,
    display carrier project removed (DEC-034..038).
    - RESET/BOOT switches removed: EN and IO9 on test points TP6/TP11 with
    RC and pull-up kept (DEC-039).
    - JLCPCB fabrication and assembly rules from the official pages in the
    KiCad DRC and placement: 2.5 mm side margins, fiducials, edge keepout,
    0.15 mm minimum track (SC-008, DEC-040, PR-REL-008, VT-PCB-001).
    - Main board 50 x 40 mm with antenna notch (DEC-036), fully routed with
    Freerouting 2.5.0: ERC 0, DRC 0 vi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
    [display.kicad_sch, mcu.kicad_sch, periferiche.kicad_sch, policlock-display-bom-completa.csv, policlock-display-bom-jlcpcb.csv, policlock-display.kicad_sch, policlock-main-bom-completa.csv, policlock-main-bom-jlcpcb.csv]
2026-11-08 hardware: symmetric USB D+/D- pair routed by hand, clean schematic parity
    - New usb_coppia.py draws the D+/D- pair with locked tracks before
    Freerouting: J1, USBLC6, R3/R4 and module pins 26/27 on one axis,
    mirror-symmetric main path with no vias, unavoidable crossover of the
    inner contacts A6/A7 with 2 vias per net; full contact-to-module paths
    equal on both plug faces (14.63 / 19.31 mm). USBLC6 flow-through with
    channels swapped in the schematic, +5V pin routed under R4 body.
    Back-side keepout keeps the GND plane continuous under the pair (DEC-041).
    - Footprints get all symbol fields and paths from the netlist; holes and
    fiducials marked board-only: schematic parity 0 issues;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
    [policlock-main-scheda.step, policlock-main.kicad_pcb, usb_alimentazione.kicad_sch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]
2026-11-08 hardware: fix edge clearance and connector courtyards
    Move C7 inward and adjust its local EN/GND routing. Complete connector courtyards and F.Fab outlines, relocate FID1 and its keepout, and add mechanical geometry checks. Include the technical review, validation evidence, updated CPL and layout exports.
    [policlock-main.kicad_pcb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]
2026-11-08 hardware+docs: verify Codex fixes and close remaining review findings
    - Independent check of 16f9bf7: REV-001/REV-003 confirmed (ERC/DRC/parity 0,
    mechanical check PASS, only C7/FID1 and local EN/GND copper changed).
    - REV-002 (DEC-042): C1 1 uF (C15849), C2 4.7 uF (C19666), 5.7 uF on VBUS.
    - REV-004: esporta.py stops on ERC/DRC violations or failed mechanical check;
    DRC with refilled zones.
    - REV-005: firmware/UI specs aligned with DEC-034 (palette dimming, Q1 power
    off at night, power sequences, NIGHT_PEEK -> DIM).
    - REV-006: title blocks rev 0.2, readable MCU notes, no RESET/BOOT mention,
    label overlaps around IO9/TP11 fixed, test point references spaced.
    - REV-007: CODEX_HANDOFF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
    [display.kicad_sch, mcu.kicad_sch, periferiche.kicad_sch, policlock-main-bom-completa.csv, policlock-main-bom-jlcpcb.csv, policlock-main.kicad_pcb, policlock-main.kicad_sch, usb_alimentazione.kicad_sch]
2026-11-08 hardware+docs: owner schematic cosmetic fixes, visual PCB review approved
    - Owner fixed remaining text overlaps in the schematic sheets (KiCad save);
    verified graphics-only: identical netlist (53 nets), ERC 0, DRC 0/0/0
    with parity, mechanical check PASS.
    - Owner visual review of the PCB in KiCad approved: OPEN-027 closed.
    - Regenerated schematic PDF, layout PDF and reports.
    [display.kicad_sch, mcu.kicad_sch, periferiche.kicad_sch, policlock-main.kicad_sch, usb_alimentazione.kicad_sch]
2026-11-08 hardware+docs: J2-J5 through-hole, hand-soldered by the owner (DEC-043)
    - J3/J4/J5: JST-SH SMD -> JST PH B4B-PH-K-S (KiCad standard footprint
    JST_PH_B4B-PH-K_1x04_P2.00mm_Vertical); J5 uses pins 1-2, pins 3-4 NC.
    - J2: SMD header C46061680 -> 1x7 2.54 mm through-hole
    (PinHeader_1x07_P2.54mm_Horizontal), pins over the top edge; pin 1 now left.
    - New symbols B4B-PH-K-S and PinHeader_1x07_P2.54_THT; field Montaggio,
    no LCSC, footprints excluded from position files.
    - PCB: J2-J5, R15, R19, R20, R21, C8 moved; affected nets rerouted with
    sbroglia_main.py --conserva (USB pair, CC, VBUS/+5V, EN untouched).
    - esporta.py: JLC BOM without hand-soldered parts, BOM/CPL consistency
    gate; verifi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
    [display.kicad_sch, periferiche.kicad_sch, policlock-main-bom-completa.csv, policlock-main-bom-jlcpcb.csv, policlock-main-scheda.step, policlock-main.kicad_pcb, policlock-main.kicad_sch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]
2026-11-08 docs: final pre-Gerber review of the main board rev 0.2
    Read-only review of commit 1241a0a (no design files changed).
    - ERC 0; DRC 0/0/0 with all severities, refill and parity; mechanical
    check PASS; USB pair identical to 4fb9200 (DEC-041); BOM/CPL match
    the PCB; all 17 LCSC codes in stock on 2026-11-08.
    - Verdict NOT READY for Gerbers: P1 FIN-001 (ESP32-C3-MINI-1-H4X is
    "Standard Only" PCBA at JLC, conflicts with Economic in DEC-040;
    edge rails needed) and P1 FIN-002 (owner visual review after DEC-043
    not recorded). P2: display power-on 3V3 dip via Q1, CPL rotations,
    back silkscreen text 0.8 mm < JLC 1.0 mm, no Gerber export procedure.
    - Reports, audit script and data in docs/re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
2026-11-08 hardware+docs: ESP32-C3-WROOM-02-N4 module, final review fixes (DEC-044)
    - U3: ESP32-C3-MINI-1-H4X (JLC "Standard Only", X-ray) -> ESP32-C3-WROOM-02-N4
    (C2934560, "Economic and Standard"). New symbol with pins at the same
    positions as the old signals; project footprint derived from KiCad's
    RF_Module:ESP32-C3-WROOM-02 (4 EPAD vias 0.3/0.7, no silk over antenna).
    - Antenna over the cut-out, widened to x = 41.51 mm; board still 50 x 40.
    - USB pair redrawn on pins 13/14 with DEC-041 criteria: 13.73/13.73 mm
    (face B), 18.41/18.41 mm (face A); J1/U1/R3/R4 unchanged.
    - FIN-003: R16 10k, C11 10 nF (C57112) gate-drain of Q1.
    - FIN-005: back silkscreen text 1.0 mm, min_text_height 1.0.
    - FIN-0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
    [display.kicad_sch, mcu.kicad_sch, policlock-main-bom-completa.csv, policlock-main-bom-jlcpcb.csv, policlock-main-scheda.step, policlock-main.kicad_pcb, policlock-main.kicad_sch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]
2026-11-08 hardware+docs: rectangular 50.5 x 41.5 mm board, antenna on board, JLC 2.5 mm rule except J1 (DEC-045)
    - Outline: rectangle 50.5 x 41.5 mm, no cut-out; grows 0.5 mm right and
    1.5 mm up, bottom-left corner fixed (J1, H1/H2, USB pair, CPL origin
    unchanged; CPL identical).
    - U3 not moved: antenna on the board towards the right edge, footprint
    keep-out (no copper/tracks/vias/fills/pads/parts) on both layers;
    body margins 3.0 mm (top) and 2.99 mm (right).
    - J2 moved up 1.5 mm with the new top edge; its nets rerouted with
    sbroglia_main.py --conserva; GND planes, edge bands and stitching redone.
    - verifica_meccanica_pcb.py: J1 is the only DFM exception.
    - ERC 0, DRC 0/0/0 with refill and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
    [policlock-main-scheda.step, policlock-main.kicad_pcb]
2026-11-08 docs: second final pre-Gerber review on a2a62a3 (WROOM-02, 50.5 x 41.5 mm)
    Read-only review after merging claude/hardware-schematic-4ff868 (a2a62a3);
    no design files changed, no Gerbers generated.
    - ERC 0; DRC 0/0/0 (all severities, refill, parity); mechanical PASS
    with J1 the only exception (U3 2.99 mm); USB pair 13.730/13.730 and
    18.406/18.406 mm, 2 vias per net, all locked; BOM/CPL = PCB (33 parts).
    - All 17 LCSC codes Economic and Standard, no X-ray (C2934560 13 098).
    - WROOM-02 pinout/strapping/EN RC checked against datasheet v1.7.
    - Verdict READY WITH RESERVATIONS, no P1. P2: R2-001 wrong pin-1 note
    for U2 (and ambiguous Q1) in the docs/12 rotation table; R2-002 stale
    post-plot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
2026-11-08 docs: close second-review reserves R2-001..R2-007
    - R2-001: rotation table in docs/12 fixed from PCB pad positions (U1, U2, Q1).
    - R2-002: esporta_gerber_jlc.py post-plot checklist updated for the
    50.5 x 41.5 mm rectangular board and antenna keep-out (script not run).
    - R2-003/R2-005: bench checks added to VT-PWR-003 and VT-PCB-002; firmware
    waits >= 2 ms after DISP_EN_N low.
    - R2-004: V2 backlog note on traces near the antenna keep-out.
    - R2-006/R2-007: EPAD check in the JLC preview, documentation residues fixed,
    docs/10 sections renumbered (13, 14).
    [esporta_gerber_jlc.py]
2026-11-08 hardware+docs: no vias in U3 EPAD, alternate CPL, J1 tabs hand-soldered
    External review of 2026-11-08 (owner's validation report):
    - DEC-046 (P2-01): removed the 4 thermal vias from the WROOM-02 EPAD in
    library and PCB; EPAD stays on GND via top copper. DRC 0/0/0, ERC 0,
    mechanical check PASS.
    - P1-01: esporta.py now also writes policlock-main-cpl-jlcpcb-u3-centro-corpo.csv
    (U3 at body centre, X 37.51 mm) to pick in the JLC preview.
    - DEC-047 (P1-02): J1 shell tabs hand-soldered by the owner after PCBA.
    - docs/10 section 15 records the review outcome; JLC preview checklist in docs/12.
    [policlock-main-scheda.step, policlock-main.kicad_pcb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]
2026-11-09 hardware+docs: J2 1x8 with BUSY pin on IO1 for a possible e-paper (DEC-049)
    - GPIO0/GPIO1 checked on ESP32-C3 datasheet v2.4 and WROOM-02 v1.7:
    not strapping, no power-up glitch, no IE/pull at reset, no 32 kHz
    crystal in the module; BUSY is a plain GPIO input (no SPI function).
    - J2 header 1x8 (pin 8 = DISP_BUSY), R23 1k (C21190, Basic) in series
    to IO1; TP10 kept on IO1; internal pull-down set by firmware.
    - PCB: J2 shifted 2.54 mm left (pin 8 would sit under U3), J2 nets and
    DISP_BUSY rerouted with --conserva, GND via under U3, stitching redone.
    USB pair, J1/U1/R3/R4, U3, antenna keepout and outline unchanged.
    - ERC 0, DRC 0/0/0 with parity and refilled zones, mechanical PASS,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
    [display.kicad_sch, mcu.kicad_sch, policlock-main-bom-completa.csv, policlock-main-bom-jlcpcb.csv, policlock-main-scheda.step, policlock-main.kicad_pcb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]
2026-11-09 docs: third final pre-Gerber review on edcef25 (DEC-046, DEC-047, DEC-049)
    Verdict PRONTO CON RISERVE, no P1. ERC 0, DRC 0/0/0 with parity and
    refill, mechanical check PASS, USB pair identical to 4780565, antenna
    keep-out clean, 18 LCSC codes Economic and Standard in stock.
    P2 R3-001: DISP_BUSY isolates the back GND plane under U3; with the
    via-less EPAD the module reaches the main back plane only through top
    copper and two vias in series. Report, ERC/DRC reports and audit saved
    in docs/revisioni/2026-11-09/revisione-finale-3; link in docs/10 §17.
2026-11-09 hardware+docs: GND vias for third-review findings R3-001..R3-005
    - R3-001: 4 GND vias 0.6/0.3 beside U3 EPAD (outside the pad, DEC-046)
    tie the top plane to the back-side island under U3, 1 via at (127.2;
    102.6) gives the U3.9/C6.2 top island a second via. Rerouting DISP_BUSY
    on U3's left side is not possible without rerouting DISP_EN_N, LCD_MOSI
    and the back +3V3 (two Freerouting attempts rejected); documented.
    - R3-003: 3 GND vias in the 249 mm2 back island (now 5 vias).
    - GND islands: under U3 2 -> 6 vias, U3.9/C6.2 1 -> 2, J2 area 1 -> 5.
    - R3-002 left open (V1 no effect): DISP_BUSY added to the V2 roadmap note.
    - R3-004: docs/04 RTC slow clock CONFIG_RTC_CLK_SRC_INT_RC, never EX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
    [policlock-main-scheda.step, policlock-main.kicad_pcb]
2026-11-09 docs: verify third-review fixes on e365648 (PRONTO PER GERBER)
    Only 8 GND vias added to the PCB since edcef25; ERC 0, DRC 0/0/0 with
    parity and refill, mechanical check PASS, USB pair identical, no via in
    the EPAD, antenna keep-out or usb_coppia_retro. Islands recounted: back
    under U3 6 vias, U3.9/C6.2 2, J2/passives 5. R3-001/003/004/005 closed,
    R3-002 open and accepted for V1. ESP-IDF v6.0/v6.1 RTC_CLK_SRC options
    checked. Addendum and reports in revisione-finale-3; line in docs/10 §18.
2026-11-10 mechanical+docs: board in the base (DEC-048), base volume study, chibi blockout
    - DEC-048: main board in the statuette's base, USB-C out the back of the base
    (closes OPEN-020, option A of DEC-021, updates DEC-018/SC-003)
    - DEC-051: chibi standing on the base; DEC-052: printing via an online service
    - build123d volume study of the base (mechanical/cad): 78.5 x 76.3 x 24.1 mm,
    board rev 0.2 unchanged, no interferences, metal >= 15 mm from the antenna
    - neutral Blender blockout and renders (assets/renders/blockout-*.png)
    - docs 00/01/02/03/06/07/08/09/10 aligned; new OPEN-031 (J2 straight or 90 deg)
    and OPEN-032 (print service)
    [base-fondo.stl, base-guscio.stl, policlock_blockout.blend, studio-volumi-base.step]
2026-11-10 docs: Gerber JLC per il preventivo, verifiche e guida al preventivo (DEC-051)
    - Gerber, forature e pacchetto per il preventivo generati dal progetto
    e365648 (a 2406b86) con esporta_gerber_jlc.py --conferma-proprietario,
    su autorizzazione del proprietario del 2026-11-10; file non versionati.
    - docs/10 §19: gate (ERC 0, DRC 0/0/0, controllo meccanico PASS),
    controlli indipendenti di Gerber/Excellon, SHA-256, scorte LCSC.
    - docs/13: guida passo passo al preventivo JLCPCB senza ordinare.
    - hardware/.gitignore: cartella jlc-quotazione/.
    - DEC-050 saltato: lo usa la sessione 3D nel worktree non unito.
2026-11-10 docs: rinumera la decisione dei Gerber JLC da DEC-051 a DEC-050
    Su indicazione dell'architetto DEC-050 e' riservato alla generazione dei
    Gerber per il preventivo; la sessione 3D rinumera le sue decisioni da
    DEC-051 in poi. Tolta la nota sul numero saltato.
2026-11-10 mechanical+docs: first voxel-style 3D concept of the statuette (DEC-053)
    - parametric build123d concept (mechanical/cad/concept_voxel.py): cube head
    70 x 64 x 70 mm with the round display as the face, cap, hair with side
    ponytail, short-sleeved shirt, belt with holster, trousers with red stripe,
    boots, on the board base; 167 mm tall, 27 parts split by colour, no
    overlaps, display module and 21 x 6 mm cable channel checked
    - Blender colours and renders (front, three-quarter, side, back with USB-C,
    exploded, section): assets/renders/concept-*.png
    - DEC-053: voxel style and stylised insignia (generic pixel emblem, "POLIZIA",
    tricolour patch), no official insignia; owner's reference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
    [banda_dx.stl, banda_sx.stl, base-fondo.stl, base-guscio.stl, base_fondo.stl, base_guscio.stl, braccio_dx.stl, braccio_sx.stl]
2026-11-10 mechanical+docs: voxel concept v2, small head with the display as the face (DEC-054)
    - owner feedback on 1afd055: longer torso (28 mm) and legs (24 mm), readable
    arms (sleeve, cuff, forearm), smaller head 48 x 40 x 48 mm where the round
    display is the whole face; total height 153 mm (was 167), base unchanged
    - display pin tab and Dupont plug go down through a T slot in the head floor
    into a cavity in the torso; head lifts off for service; cable path ~68 mm,
    10 cm Dupont still enough
    - renders with the clock and with an emoji face (concept-*-emoji.png), side,
    back, exploded, section
    - docs/05: owner's "emoji face" idea for the future firmware, open questions
    only; docs/06 section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
    [banda_dx.stl, banda_sx.stl, base-fondo.stl, base_fondo.stl, braccio_dx.stl, braccio_sx.stl, busto.stl, cappello.stl]
